ssingh-tamu/The-Only-WGT-FinalGIT/README.md

# The-Only-WGT-FinalGIT
ECEN CAPSTONE: 2 Channel Arbritrary Waveform Generating team #25 at TAMU. 

GitHub Repository: You must add your Instructors (kjnowka, pranav-d1993, johnlusher, skalafatis) and your TA as Collaborators. 

Sponsor:
Dr. John Lusher (johnlusher)

TA:
TBD
 
Contents:
Project data, reports, presentations, code, measurements, plans, and results. 

How to use code:
Download code as a zip file and run locally on personal device
Mobile App: Use VScode or other compatible IDE and Arduino IDE to start BLE search
