ssingh-tamu/The-Only-WGT-FinalGIT/Meeting Notes/Master Requirements- Summary from Lusher Meeting 1.docx

https://lucid.app/lucidchart/253e77ca-8b81-4c0a-8e63-2cc6b063a174/edit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

Master Requirements Document 1. System Overview

The project is a portable waveform generator with FPGA-based control and app-driven interface.
It must provide high-resolution, configurable signals across a range of frequencies, support standard lab equipment compatibility, and balance performance, portability, and usability.

System Objectives

- Generate high-quality arbitrary waveforms with 16-bit resolution.
- Provide portable and user-friendly operation with app-based control (ESP32).
- Ensure compatibility with standard lab measurement equipment (e.g., 50 Ω loads, BNC jacks).
- Demonstrate core capabilities in a 5-minute demo (signal generation, load driving, waveform control).

Key Design Constraints

1. Performance Limits
  - Sampling rate: ~1 MHz max (1M samples/sec).
  - Nyquist compliance: ≥2× rate required for 500 kHz signals (avoid aliasing).
  - Output frequency: 100 kHz max usable waveform frequency.
2. Resolution & Output Specs
  - 16-bit DACs (2 channels, parallel-based).
  - Output voltage: ±5 V.
  - Must drive 50 Ω load.
3. Form Factor & Portability
  - Device must fit into a “nice enclosure.”
  - Table-top form factor.
  - Thermal management (heatsinks/grounding for DC/DC converters)
4. Power
  - 12V DC Wall Plug
  - Must handle subsystem rails (FPGA, MCU, DAC, Op Amps, SRAM, etc.).
5. Interface
  - No onboard interface required → App-based UI preferred.
  - Must allow waveform preview/control via phone app.
  - Optional: local display for debugging.

Required Features

- Signal Generation
  - Waveforms: sine, sinc, triangle, trapezoid, invert.
  - User-defined / Optional: drawable waveforms.
  - Memory-backed waveform playback (FPGA + SRAM).
- FPGA Functionality
  - Index counter for waveform stepping.
  - RAM integration.
  - Load/playback control logic.
  - Configurable playback speed.
- Connectivity & App
  - App controls waveform generation, parameters, and playback.
  - Wireless communication via ESP32..
- Enclosure & I/O
  - BNC jacks for output.
  - Grounded, shielded enclosure.
  - Compact, user-friendly design.

Specifications Summary

Parameter | Requirement
DAC Resolution | 16-bit, 2 channels
Max Sampling Rate | Minimum ~1 MHz (1M samples/sec)
Max Output Frequency | Minimum: ~100 kHz
Output Voltage Range | ±5 V
Output Load | 50 Ω
Coupling | Selectable AC/DC
Waveforms Supported | sine, sinc, triangle, trapezoid, invert, custom
Memory | SRAM for waveform storage
Controller | FPGA (index counter, RAM, playback)
User Interface | IOS App (ESP32-based)
Ports | 2 BNC connectors (to connect to oscilloscope)
Power Options | DC 12V Wall Power

7. Demo Deliverables (Dec. 2)

- Demonstrate 16-bit waveform generation at ±5 V.
- Show multiple waveforms (sine, sinc, triangle, trapezoid, invert, etc).
- Control waveform parameters via app (ESP32).
- Prove ability to drive a 50 Ω load.
- Demonstrate clock speed control and waveform playback from memory.
