ssingh-tamu/The-Only-WGT-FinalGIT/Final Demo 403.docx

Csv capture command

(captures serial output of receiving esp which is what it is receiving via SPI)

py capture_csv.py COM3 115200

Standard Commands

Size: A standard STD packet is 17 bytes (136 bits): 'S' (1) + shape (1) + freq_mHz (4) + amp_mVpp (4) + offset_mV (4) + phase_deg (2) + channel (1).

Parsing: Check d[0] == 'S',read fields in order from d[1+] into StdParams (1-byte shape, then 4-byte LE freq_mHz, 4-byte LE amp_mVpp, 4-byte LE offset_mV, 2-byte LE phase_deg, and final 1-byte channel).

Sine

py send_awg.py --mode std --channel 0 --shape 0 --freq 1000 --vpp 6 --ofs 0 --phase 0

Square

py send_awg.py --mode std --channel 0 --shape 1 --freq 1000 --vpp 6 --ofs 0 --phase 0

Triangle

py send_awg.py --mode std --channel 0 --shape 2 --freq 1000 --vpp 6 --ofs 0 --phase 0

Sinc

py send_awg.py --mode std --channel 0 --shape 3 --freq 1000 --vpp 6 --ofs 0 --phase 0

Arb Command

Size/structure: ARB uses three packet types — META: 6 bytes ('A' + channel(1) + freq_mHz(u32)), DATA: 3 + 2*count bytes ('D' + count(u16 LE) + count×u16 LE samples), and END: 1 byte ('Z').

Parsing: Check d[0] and if it’s 'A' reset state and store channel + freq_mHz, if it’s 'D' verify n == 3 + 2*count and append the samples into arb_buf, and if it’s 'Z' then commit only if META was seen and exactly 1024 samples have been received.

py send_awg.py --mode arb --channel 0 --freq 1000 --file "C:\Users\knipp\Downloads\Capstone\arb_squiggle_1024.csv"

Code notes

Diff between arb and standard - It just looks at the first byte of the BLE packet. If it starts with 'S' it treats it as a standard packet; if it starts with 'A', 'D', or 'Z' it treats it as part of the arbitrary (ARB) protocol.

In my firmware, the ESP32-S3 is the SPI master and the FPGA is the SPI slave, so my code shifts 5-byte command frames (with opcode, address, and data) from the ESP32 into the FPGA whenever you write LUT samples or a frequency tuning word. Each fpga_spi_write_sram_sample or fpga_spi_write_nco_ftw call just packs those bits into a frame and uses SPI to clock them over the SCK/MOSI/CS pins so the FPGA can update its waveform memory and NCO

wavegen.cpp – This file defines the waveform parameters, the basic math for sine/square/triangle/sinc, and converts requested volt values into 16-bit DAC codes for a ±5 V range. It fills 1024-sample LUTs by stepping through phase, writes those samples into the FPGA’s SRAM over SPI, and computes/loads the NCO frequency tuning word based on the requested frequency. There are two main entry points: one that builds “standard” waveforms from parameters and one that uploads an arbitrary 1024-sample waveform array.

main.cpp – This is the Arduino entry point that initializes Serial, configures the SPI pins and clock for talking to the FPGA, and prints a short boot message. It calls the SPI setup function with specific ESP32-S3 pins (SCK=11, MOSI=9, CS=12) at 1 MHz, then starts BLE. The main loop just runs the BLE handler so incoming packets can trigger waveform updates.

fpga_spi.cpp – This file sets up the ESP32 FSPI bus with the chosen SCK/MOSI/CS pins and defines a simple 5-byte command frame with 3-bit opcodes in the first byte. Helper functions pack address and data or the frequency tuning word (FTW) into these frames and toggle chip select with a small delay so the FPGA can latch the data. It exposes two C-style functions: one to write a 16-bit sample into a selected SRAM bank/address and one to send a 32-bit FTW to the chosen NCO.

ble.cpp – This file creates a Nordic UART-style BLE service named “ESP32-JOE” with RX (write) and TX (notify) characteristics and tracks whether a client is connected. In the RX callback it parses legacy “STD” packets starting with ‘S’ into a StdParams struct (shape, frequency, amplitude, offset, phase, channel) or new “ARB” packets using a three-step protocol with ‘A’ for meta, ‘D’ for data chunks, and ‘Z’ for end. After a valid command is parsed, it calls the appropriate wavegen function to build and load either a standard LUT or an arbitrary LUT into the FPGA and update the frequency.
