ssingh-tamu/The-Only-WGT-FinalGIT/Final Demo notes.docx

Show that

- Bluetooth connectivity
- Can receive and parse all standard waveforms (sine, square, triangle, sinc) correctly across all value ranges (0 - 100khz, 0-10vpp, -5 to 5 offset, -180 to 180 phase)
- Can receive arbitrary meta and point data correctly
- Can produce 64k LUT and ftw correctly for all cases
- Can send it to a device via SPI
