ssingh-tamu/The-Only-WGT-FinalGIT/Power and Filter/Power and Filters.docx

Questions

Power

1. Should the DC/DC converter be buck, boost, buck boost, or inverters?
2. Will there be a mix of converters as each subsystem has its own specific rail needs? (This is a multi-rail power supply system)
3. Linear or Switching regulators? Or both?
4. What protections are necessary/should be considered for the power supply subsystem?
5. What is the main input? (battery?)
6. Main input: 12V Wall adapter (AC/DC Power Supply), Battery (Li-ion/Polymer), or Hybrid?
7. Switching buck for heavy digital loads -> LDOs to clean sensitive analog rails separate stage for high-voltage analog
8. Use of POL rails/implement a POL strategy/implement a POL architecture: the central source is the 12V adapter, and there will be POL converters (buck, boost, LDOs)

^ 12V adapter is the root of the system

^ from the 12V adapter, multiple POL converters branch out, each optimized for a subsystem, preventing one “noisy branch” from corrupting the whole system

Digital Circuits (Microcontrollers, FPGA): use switching buck regulators. Digital is mostly immune to noise, so a switcher’s noise won’t be too big of a problem

Analog Circuits (DAC): Use LDO due to needing near-perfect, noise-free rail. The power loss in using a LDO is acceptable because the needed current is low.

^ what type of linear regulator, aside from LDO (low-dropout regulator)? What about standard?

Note: The efficiency of switchers where it matters (Digital). The clean, quiet performance of LDOs where it’s critical (Analog).

*ensure that the components match the frequency

* use multisim/LTSpice or Proteus for simulation

* TA recommends 1-2 simulation before buying parts

### POL (Point of Load) Breakdown

1. Digital Rail (Buck 12V → 3.3V) [12 V → buck → 5 V → LDO → clean 3.3 V]
  - Powers MCU, FPGA, and Memory.
  - High current, efficient conversion.
  - Some digital noise is okay here.
2. Clean Analog Rail (LDO 3.3V)
  - Derived from 12V (or a 5V intermediate).
  - Powers DAC, because DACs need low-noise supplies to avoid introducing distortion.
3. Reference Rail (LDO 2.5V/Precision Voltage Reference IC)
  - Precision supply for DAC reference.
  - Like a ruler for the DAC’s output steps.
4. Isolated ±15V Rail (Isolated DC/DC)
  - Feeds Op-Amps and Filters.
  - Higher voltage allows rail-to-rail swing for strong analog outputs.
  - Isolation shields analog from digital ground noise.

IMPROVED POL (Point of Load) Breakdown

[12 V → buck → 5 V → LDO → clean 3.3 V]

1. Intermediate Distribution Rail

Rail Name: +5V_BUS

Voltage: +5V

Regulator Type: Switching Buck Converter (High-Efficiency)

Purpose: This is not a POL rail itself. It is an intermediate bus voltage. Its job is to efficiently step down the main 12V input to a lower voltage that all the subsequent POL regulators can use. This is more efficient than having each POL regulator step down directly from 12V.

Powers: The input to all the following POL regulators.

2. Digital Rails (Noisy, High-Current)

a) Digital I/O Rail

Rail Name: +3V3_DIG

Voltage: +3.3V

Regulator Type: POL Switching Buck Converter

Powers: FPGA I/O Banks, Microcontroller (MCU), Memory (RAM/Flash).

Why: These components are noisy and draw significant current. A high-efficiency buck converter is perfect. The 3.3V value is a standard voltage for modern digital logic ICs.

b) FPGA Core Rail (CRITICAL)

Rail Name: +1V2_CORE

Voltage: +1.2V (or as required by your specific FPGA)

Regulator Type: POL Switching Buck Converter (Must be placed very close to the FPGA)

Powers: The internal core logic of the FPGA.

Why: The FPGA core is the most demanding load: very low voltage, very high current, and extremely noisy. It must have its own dedicated POL regulator to ensure stability and prevent noise from spreading across the board.

c) DAC Digital Supply Rail

Rail Name: +3V3_DIG (or +1V8_DIG if needed)

Voltage: Set by DAC datasheet (often 3.3V or 1.8V)

Regulator Type: Ferrite Bead + Capacitor (Filtered from the +3V3_DIG rail)

Powers: The digital supply pin (DVDD) of the DAC.

Why: The DAC's internal digital logic is noisy. It is best practice to power it from the digital rail but add a simple filter (a ferrite bead and capacitor) to prevent its noise from going back into the main digital supply. This is often called a "pi filter."

3. Analog Rails (Clean, Low-Noise)

a) DAC Analog Supply Rail

Rail Name: +3V3_ANA

Voltage: +3.3V (or as required by the specific DAC)

Regulator Type: POL Low-Dropout (LDO) Regulator

Input: Powered by the +5V_BUS.

Powers: The analog supply pin (AVDD or VAA) of the Digital-to-Analog Converter (DAC).

Why: The DAC's analog circuitry is highly sensitive to power supply noise, which would directly corrupt the output waveform. The LDO takes the somewhat noisy +5V_BUS and produces a ultra-clean, low-noise rail for the DAC.

b) Precision Reference Rail (The "Master Ruler")

Rail Name: +2V5_REF

Voltage: +2.5V (or as required by the specific DAC)

Regulator Type: Precision Voltage Reference IC (This is not a regulator for power!)

Powers: Nothing. It provides a reference voltage.

Purpose: It connects to the DAC's reference input pin (VREF). This IC defines the DAC's full-scale output voltage. Its sole job is to be an absolutely stable, precise, and noise-free "ruler." If this voltage is wrong, every output voltage from the DAC is wrong.

4. Output Stage Rails (High Voltage, Isolated Dual Output DC/DC Converter Module)

Rail Name: +5V_ANA and -5V_ANA

Voltage: ±5V

Regulator Type: Isolated DC/DC Converter (or a non-isolated inverting converter for the negative rail if isolation isn't needed)

Powers: The output stage operational amplifiers (op-amps) and any associated filters.

Why:

Voltage Swing: The op-amps need a higher voltage supply (±15V) to generate large output signals (e.g., ±10V).

Bipolar Output: The negative rail (-15V) allows the output to swing below ground (0V), which is essential for standard waveforms like sine waves.

Isolation: The isolation creates a separate "analog ground" plane, shielding the sensitive output stage from the noisy "digital ground" plane.

*will need power jack soldered onto the board to plug in the wall adapter. During testing, solder the black and red wires to the footprint of the power jack

*may need extra rail to Memory

Load | Regulator Type | Input | Output | Purpose
Intermediate Bus Converter | Switching Buck | 12V Input | +5V_BUS | Efficiently steps the 12V input down to a lower voltage, typically 5V. This new +5V_BUS rail becomes the new, main power distribution rail for the entire board.
Digital Logic (FPGA I/O, MCU) | Switching Buck | +5V_BUS | +3.3V_DIG | Efficiently powers noisy, high-current digital chips.
FPGA Core | Switching Buck | +5V_BUS | +1.2V_CORE | Efficiently powers the hungry, noisy FPGA core. Must be very close to the FPGA.
DAC Analog Supply | LDO | +5V_BUS | +3.3V_ANA | Creates a clean rail from the noisy +5V_BUS for the sensitive DAC analog circuits.
DAC Digital Supply | Pi Filter | +3.3V_DIG | +3.3V_FILT | Filters noise from the digital rail for the DAC's digital pins. (Ferrite bead + capacitors).
DAC Reference Voltage (VREF) | Precision Voltage Reference IC | +3.3V_DIG or +5V_BUS | +2V5_REF | It connects to the DAC's reference input pin (VREF). This IC defines the DAC's full-scale output voltage. Its sole job is to be an absolutely stable, precise, and noise-free "ruler." If this voltage is wrong, every output voltage from the DAC is wrong.
Output Op-Amps | Isolated DC/DC Converter | 12V Input | ±5V_ANA | Creates high-voltage, isolated rails for the output stage to swing large signals.
Output Stage Op-Amps (Cleanup) | LDO Regulators (Optional) | ±5V_ANA | ±5V_CLEAN | Further cleans the noisy output of the isolated converter, providing pristine power to the most sensitive op-amps.

Rail Organization

Subsystem | Rail Name | Purpose | Voltage | Critical Requirements
MCU | +3.3V_DIG | Powers the MCU, FPGA I/O pins, and general digital logic. | +3.3V | N/A
Memory | +1.5V_DDR | | +1.5V | N/A
Memory | +0.75V_VTT | | +0.75V | Must source/sink current
FPGA | +1.2V_CORE | | +1.2V | High Current, Low Noise
FPGA | +3.3V_DIG | | +3.3V | N/A
DAC | +3.3V_ANA | | +3.3V | Ultra-Low Noise
DAC | +3.3V_FILT | | +3.3V | Filtered
DAC | +2.5V_REF | | +2.5V | Precision, Stability
Filter + Amp | +15V_ANA | | +5V | Isolated from Digital GND
Filter + Amp | -15V_ANA | | -5V | Isolated from Digital GND
Enclosure | +3.3 | Indicator Lights | 2.1V | Resistor in Series to nudge input voltage down a little

MCU

Rail: +3.3V_DIG

Memory (DDR)

Core Rail: +1.5V_DDR (for memory chips' VDD)

Termination Rail: +0.75V_VTT (for signal integrity)

FPGA

Core Rail: +1.2V_CORE (for internal logic)

I/O Rail: +3.3V_DIG (for bank voltages)

DAC

Analog Supply Rail: +3.3V_ANA (for AVDD)

Digital Supply Rail: +3.3V_FILT (for DVDD, Pi Filter branching from Analog Supply Rail)

Reference Rail: +2.5V_REF (for VREF)

Filter + Amplifier (Output Stage)

Positive Rail: +5V_ANA

Negative Rail: -5V_ANA

### DUAL DAC DESIGN FOR TWO-CHANNEL (how will this affect the power design?)

Filter

1. Revision 1:

DAC output → low-pass to smooth signal → offset summing Amp + variable gain amp → output buffer amp → high-pass (AC coupling, blocks DC) → over-current + short-circuit protection → output

2. Revision 2:

DAC output → local RC → reconstruction LPF → diff→single (if needed) → offset summing amp + PGA → final buffer/driver → selectable AC coupling (relay bypass for DC) → TVS + current sense + active limiter → output connector (switchable 50Ω pad)

3. Revision 3 (Current-output DAC):

DAC -> I-V Converter (opamp) -> Reconstruction LPF -> Variable Gain Amp (VGA) -> Offset Summing -> Output Buffer

4. Revision 4 (Voltage-output DAC):

Voltage-Output DAC -> Reconstruction LPF -> Variable Gain Amp (VGA) -> Offset Summing -> Output Buffer

Stage Purpose User Control

Reconstruction LPF Smooths the DAC's stairsteps No (Fixed by design)

PGA (Amp Stage) Sets the output amplitude Yes (Via App)

Output Buffer Provides current, low impedance No (Always on)

Protection Guards against shorts/ESD No (Always on)

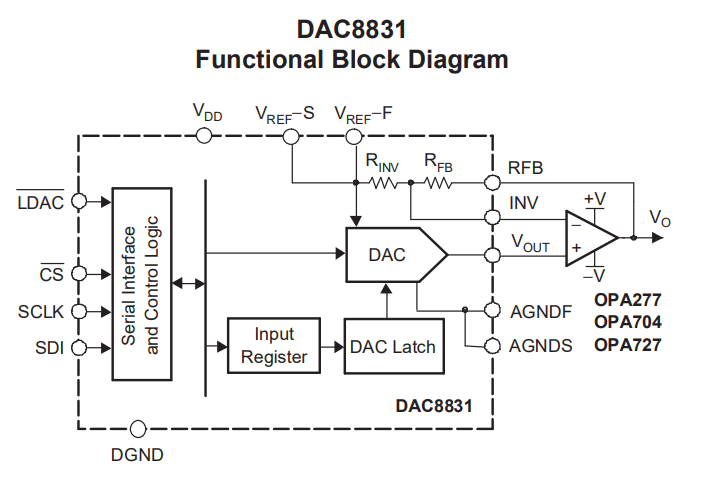
[picture p5: figure]

Videos

- https://www.youtube.com/watch?v=XYrpfNqrRRY

—----------------------------------------------------------------------------------------------------------------------------

Additional Notes:

The Workflow

The Microcontroller (running firmware) handles the "brain" tasks: communicating with the iPhone/Android app, reading the stored waveform from memory, and configuring the FPGA.

The FPGA (running the custom logic) handles the "brawn" tasks: reading the waveform data at a precise, high-speed rate from memory and streaming it to the DAC. This is its core job.

The DAC takes the high-speed digital number stream from the FPGA and converts it into a stepped analog signal.

The Analog Stage (Filter and Amplifier) smooths the DAC's stepped output into a clean waveform and amplifies it to the desired voltage level.

The Power's Job: Is to keep all of this running without any part of the system causing another part to misbehave. The digital switching noise from the FPGA and memory must not leak into the analog stages, which is why we use separate, filtered POL rails and careful layout.

### Subsystem Dependencies

- App → MCU: The phone app sends commands (frequency, waveform shape) to the microcontroller.
- MCU → FPGA: The MCU configures the FPGA and tells it what waveform data to use.
- FPGA ↔ Memory: FPGA pulls waveform samples from memory.
- FPGA → DAC: FPGA clocks digital samples into the DAC.
- DAC → Op-Amps + Filters: DAC produces a staircase signal, which op-amps filter and buffer into smooth analog waveforms.
- Op-Amps + Filters → Output: Final waveform goes to the user.

—----------------------------------------------------------------------------------------------------------------------------

### 1. Where are the waveforms stored?

- Memory (Flash, SDRAM, or SRAM) stores the waveform tables (e.g., sine, triangle, custom user-defined shapes).
- Think of memory as a library of sheet music.

### 2. Role of the MCU

- The MCU is like the conductor. It doesn’t play the waveform itself, but it decides:
  - Which waveform to use (sine, square, etc.).
  - At what frequency/amplitude to play it.
  - When to start/stop.
- The MCU gets these instructions from the App (via USB, Bluetooth, WiFi, etc.).
- The MCU then configures the FPGA:
  - Tells it where in memory to look.
  - Tells it what playback rate (sample clock divider).
  - Sets channel parameters (Ch1 vs Ch2).

### 3. Role of the FPGA

- The FPGA is the sheet music player — very fast, very parallel.
- Once the MCU sets it up, the FPGA:
  - Reads digital samples from memory (at the right speed).
  - Streams them out as a sequence of numbers to the DAC.
  - Can handle two channels independently (since you want two different frequencies at once).

### 4. Role of the DAC

- The DAC is the instrument that turns digital sheet music (sample numbers) into real analog voltages.
- It outputs a “staircase” approximation of the waveform.

### 5. Role of the Analog Output Stage

- Op-amps + filters are the sound engineers:
  - Smooth out the DAC’s staircase (low-pass filter).
  - Buffer the signal so it can drive cables/loads.
  - Scale amplitude if needed.

Note

Nyquist: sampling rate is 2x the frequency (otherwise, alias)

Limit DAC to 1MHz, fastest signal is 100kHz

2 DAC

Ram holds waveform

16-bit DAC

1Mega sample/sec

FPGA has to load memory: loadback() and configuration (talk to app to download waveform)

Output of opamp no good, need filter

50ohm impedance load

—----------------------------------------------------------------------------------------------------------------------------

### INFORMATION NEEDED FOR POWER DESIGN

MCU - ESP32

https://www.espressif.com/sites/default/files/documentation/esp32-wroom-32_datasheet_en.pdf

Parameter | Purpose | Where to Find It | Value
Core Voltage | Power | https://www.espressif.com/sites/default/files/documentation/esp32-wroom-32_datasheet_en.pdf | 3-3.6 (V)
Core Current (Max) | Power | Same | 0.5A minimum
I/O Voltage | Control | Same | VDD
Any Special Rails

FPGA - https://docs.amd.com/v/u/en-US/ds162

Parameter | Purpose | Where to Find It | Value
Core Voltage (VCCINT)
Core Current (Max)
I/O Bank Voltages (VCCIO)
I/O Bank Currents
Auxiliary Voltage (VCCAUX)
Auxiliary Current
Power-On / Off Sequence

Memory - https://www.issi.com/WW/pdf/62WV12816ALL.pdf

Parameter | Purpose | Where to Find It | Value
Type & Part Number
Core Voltage (VDD)
Core Current (Max)
Termination Voltage (VTT)
I/O Voltage (VDDQ)

DAC - TI DAC 8820

chrome-extension://efaidnbmnnnibpcajpcglclefindmkaj/https://www.ti.com/lit/ds/symlink/dac8820.pdf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

Parameter | Purpose | Where to Find It | Value
Analog Supply Voltage (AVDD/VAA)
Analog Supply Current (I_AVDD)
Digital Supply Voltage (DVDD) | Power | datasheet | 2.7-5.5
Digital Supply Current (I_DVDD) | power | datasheet | 3-5uA
Reference Input Voltage (VREF) | Analog output | datasheet | N/A Depends on analog ref around it Analog Output Stage filter section
Reference Input Current (I_VREF)

Analog Output Stage Filters

Parameter | Purpose | Where to Find It | Value
Op-Amp Supply Voltage Range
Op-Amp Supply Current (per amp)
Output Voltage Swing
