ssingh-tamu/The-Only-WGT-FinalGIT/PCB/PCB Notes.docx

- S3 can work with just usb recep
- So we can exclude cp2102n and USB to UART
- Also dont need auto program circuit can exclude that
- chrome-extension://efaidnbmnnnibpcajpcglclefindmkaj/https://dl.espressif.com/dl/schematics/SCH_ESP32-S3-DevKitC-1_V1.1_20221130.pdf
- es

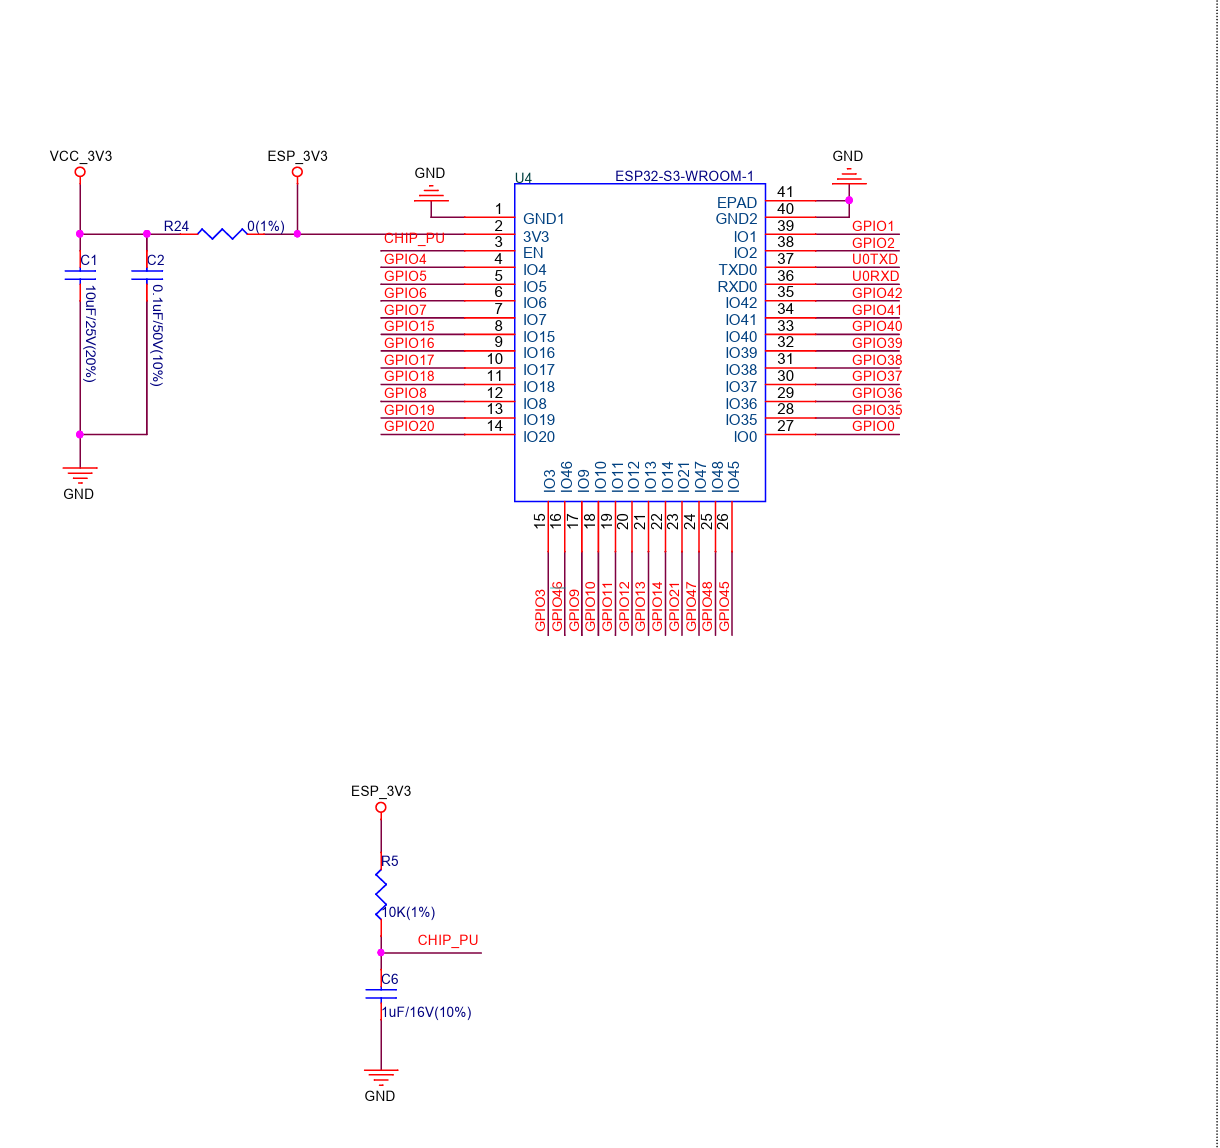
[picture p6: figure]
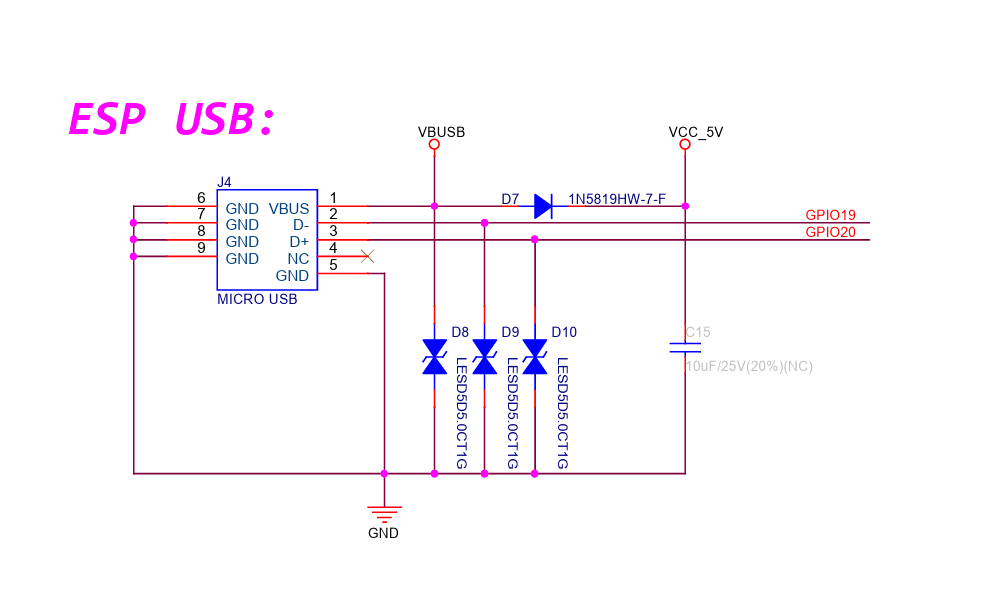
[picture p7: figure]
