ssingh-tamu/The-Only-WGT-FinalGIT/Meeting Notes/10_27 Notes.docx

Zoom Link: https://us04web.zoom.us/j/73251880836?pwd=7DvYnqgihGabgiac9zAaB7KOCzAVjC.1

To Do:

- Subsystem Updates
- Status Update Slides

Notes:

Serene:

- On track with subsystem, finished slides

Brayden:

- Ordered PCB will arrive Nov 2nd, will practice soldering tmr, will start coding tmr, slides finished

Joe:

- Slides finished, plans to populate pcb tmr

Be ready to do a couple dry run presentations tmr during the lab!!!
