ssingh-tamu/The-Only-WGT-FinalGIT/Meeting Notes/9_2_ Introductions Meeting.docx

To Do:

- Introductions + Backgrounds
  - Technical Strengths/Weaknesses
- Compile Team Schedules
  - Set up regular meeting times
- Talk about Project
- Subsystem Brainstorming

Project Overview:

Design and implement an Arbitrary Waveform Generator (AWG) capable of generating two independent analog waveforms, each at different user-defined frequencies, based on pre-stored waveform data. Users will control the AWG through a mobile app (iOS/Android?), which communicates with the hardware system comprising:

- Microcontroller (MCU) for control and interface logic
- FPGA for high-speed waveform generation
- External memory to store arbitrary waveform data
- Digital-to-Analog Converters (DACs) for converting digital waveforms to analog
- Analog output stages with filters to clean the signal
- DC/DC converters for power regulation

Goal:

This system will allow users to choose waveform shapes, frequency, amplitude, and output channels via the app and transmit those settings to the hardware.

Main Features:

1. Dual-channel waveform output
2. User-defined waveform selection (stored in memory)
3. Frequency and amplitude control
4. Mobile app interface
5. Analog output with filtering
6. DC power regulation for portability

Flow Chart:

[ Mobile App ] <--Bluetooth/WiFi--> [ Microcontroller ] <---> [ FPGA ]

[ External Memory (Waveforms) ]

[ Dual DACs ] ---> [ Analog Filters ] ---> [ Output ]

[ Power: DC/DC converters ]

Subsystems:

Subsystem | Main Role | Key Components
Mobile App | User interface & control | Flutter/React Native, BLE/WiFi
Microcontroller | System coordination & communication | STM32, ESP32, Teensy
FPGA | Digital waveform generation | Xilinx/Lattice FPGA, DDS/NCO logic
External Memory | Stores waveform data | QSPI Flash, SRAM
DAC | Converts digital to analog | DAC8562, AD9708
Analog Output Stage | Filters and buffers analog signals | Op-amps, RC filters
Power Supply | Regulates all system voltages | DC/DC converters, LDOs
Communication Buses | Transfers data between components | SPI, UART, I2C, parallel

Potential Team Responsibility Breakdown:

### Team Member 1: Mobile App & Communication Interface

Main Focus: User Interface, App Logic, and Communication with MCU

#### Responsibilities:

- Design and implement the mobile app UI (iOS & Android)
- Allow user to:
  - Select waveform type
  - Set frequency & amplitude
  - Start/stop waveform output
- Implement Bluetooth or WiFi communication
- Define and document the data protocol (e.g., JSON or binary messages) between app and MCU
- Implement feedback/status display from device

#### Tools:

- Flutter (cross-platform), or Swift (iOS) + Kotlin (Android)
- BLE or WiFi (TCP/UDP) stack
- Serial monitor & mobile debugging tools

#### Interfaces With:

- Team Member 2 (MCU)
- Must define command structure early to enable parallel work

### Team Member 2: Microcontroller Firmware & System Controller

Main Focus: Command parsing, communication handling, and FPGA configuration

#### Responsibilities:

- Set up and manage Bluetooth/WiFi connection on MCU
- Receive commands from mobile app
- Parse commands and generate control signals for FPGA (e.g., waveform ID, frequency values)
- Initialize system peripherals
- Optionally handle waveform data loading into external memory
- Provide status messages back to app
- Handle power-on/reset sequencing for the system

#### Tools:

- C/C++ or Arduino framework
- STM32CubeIDE, PlatformIO, or ESP-IDF
- UART/SPI/GPIO to interface with FPGA

#### Interfaces With:

- Team Member 1 (App)
- Team Member 3 (FPGA): Define control protocol for waveform config
- Team Member 4 (Power/Analog): May need to coordinate power control sequencing

### Team Member 3: FPGA Logic Design & Memory Interface

Main Focus: High-speed waveform generation and data playback logic

#### Responsibilities:

- Implement dual-channel waveform generator using:
  - DDS (Direct Digital Synthesis) or counter-based playback
- Create finite state machine (FSM) for:
  - Reading waveform data from memory
  - Handling dual output synchronization
- Interface with:
  - External memory (QSPI/SRAM)
  - DAC (SPI or parallel)
- Accept configuration parameters from MCU (via SPI/UART/GPIO)
- Provide waveform timing accuracy and channel separation

#### Tools:

- Verilog/VHDL, Vivado or Lattice Diamond (depending on FPGA)
- ModelSim/ISE for simulation
- Testbench development

#### Interfaces With:

- Team Member 2 (MCU): Define config protocol
- Team Member 4 (DAC/Analog): Define DAC signal format and timing

Team Member 4: Analog Output Stage, DAC, and Power System

Main Focus: Convert digital samples to analog, filter and amplify output, and manage power regulation

#### Responsibilities:

- Select and configure DACs (dual-channel or two separate)
- Design analog output filters (anti-aliasing, op-amp buffers)
- Design and build power supply system:
  - DC-DC converters (buck/boost)
  - Clean power rails for analog, digital, and FPGA sections
- Perform signal integrity testing (oscilloscope measurements)
- Assist in PCB layout for mixed-signal performance (digital/analog isolation)
- Handle signal conditioning for both waveform channels

#### Tools:

- LTSpice, Altium/KiCad, Oscilloscope, Signal generator
- Power supply modules or custom DC/DC design
- Soldering/debug tools for analog prototyping

#### Interfaces With:

- Team Member 3 (FPGA): DAC input format & timing
- Team Member 2 (MCU): Ensure sequencing or enable pins for power control

Meeting Notes:

Potential Subteams

App/ Mem

Microcontroller

DAC FPGA

Power/Analog (Note: would need current draw table from components in other subsystems)

Notes/References:

DIY a Signal Generator: https://www.instructables.com/DIY-FunctionWaveform-Generator/

$20 AWG: https://www.instructables.com/Arbitrary-waveform-generator/

Function Generator: https://www.allaboutcircuits.com/projects/how-to-DIY-waveform-generator-analog-devices-ad9833-ATmega328p/

Homemade DAC: https://www.instructables.com/Homemade-Quality-DAC-Is-Easy/

DAC AD Converter: https://www.instructables.com/Homemade-DAC-AD-Converter/

DIY Analog Function Generator (reference): https://www.reddit.com/r/electronics/comments/17tij5x/my_diy_analog_function_generator_i_built_a_two/

Digital Direct Synthesis https://www.analog.com/en/resources/analog-dialogue/articles/all-about-direct-digital-synthesis.html

Meeting with Lusher Questions: QUESTIONS DUE 9/3 MIDNIGHT

Sorted List by Category:

1. System Design & Architecture
  a. Can we buy a DAC or do we have to make our own?
  b. What kinds of microcontrollers can we use? Is there anything we can’t use the microcontroller to do, like store the memory of the signal?
  c. Should the DC/DC converter be buck, boost, or buck boost?
  d. Power constraints: sourcing
  e. What protections are necessary for the power supply subsystem?
  f. Local or Cloud Memory?
2. Specifications & Performance
  a. Design specs?
  b. What should the resolution of the output signal be?
  c. What is the maximum output frequency and useful signal bandwidth per channel?
  d. What is the Frequency range?
  e. What is maximum amplitude?
  f. What are the required DC accuracy?
  g. How many values per arbitrary waveform period?
3. User Interface & Display
  a. Do we need a display on the waveform generator?
  b. Does any data need to be displayed on the phone app that needs to be communicated back from the waveform generator?
4. Power & Portability
  a. Portability constraints? Should this device be a table-top machine or a handheld device?
  b. Battery Life constraints? Wireless capabilities
5. Functionality & Use Cases
  a. What is the primary intended application for the AWG? Should the signal be tested against different \[loads/environments]?
  b. Should we have preset waveforms (square, triangle, sin, etc)?

Design Specifications:

- Filtering + Power → Salina
- DAQ + FPGA → Brayden
- Team Spokesperson+ Mobile Device + Communication Interface → Serene
- Microcontrollers + Current Waveform Generators Stats Sheet + Feasibility → Joe

Assignment:

- Research your subsystem and determine scope and feasibility
- Ideally, how would your subsystem work?
- Create a list of materials you’d need to purchase
- Suggest a game plan for your subsystem
  - Outline What parameters you need and from what subsystem
  - Outline what parameters you will provide and for what subsystem
- Create soft deadlines for your subsystem

TA Office

11-1 Mondays

ConOp Report Due in 2 weeks
