ssingh-tamu/The-Only-WGT-FinalGIT/Meeting Notes/9_4  Meeting w_Lusher FINIAL Q.docx

Meeting with Lusher Questions: QUESTIONS DUE 9/3 MIDNIGHT

Sorted List by Category:

1. System Design & Architecture
  a. Can we buy a DAC or do we have to make our own?
  b. What kinds of microcontrollers can we use? Is there anything we can’t use the microcontroller to do, like store the memory of the signal?
  c. Power constraints: sourcing
  d. What protections are necessary for the power supply subsystem?
  e. What will be the exact purposes for the output filters?
  f. Local or Cloud Memory?
2. Specifications & Performance
  a. Design specs?
  b. What should the resolution of the output signal be?
  c. What is the maximum output frequency and useful signal bandwidth per channel?
  d. What is the Frequency range?
  e. What is maximum amplitude?
  f. What is the required DC accuracy?
  g. How many values per arbitrary waveform period?
  h. What output voltage ranges do we need?
  i. What load impedances must we support?
  j. Do we want both AC-coupled and DC-coupled outputs, or only one? (allow selectable AC coupling?)
3. User Interface & Display
  a. Do we need a display on the waveform generator?
  b. Does any data need to be displayed on the phone app that needs to be communicated back from the waveform generator?
4. Power & Portability
  a. Portability constraints? Should this device be a table-top machine or a handheld device?
  b. Battery Life constraints? Wireless capabilities
  c. Main input: 12V Wall adapter (AC/DC Power Supply), Battery (Li-ion/Polymer), or Hybrid?
  d. Do we need isolated power rails for analog and digital sections, or is careful grounding enough?
  e. Is thermal management (heatsinks, airflow) a concern for the DC/DC converters or LDOs?
  f. What are the required voltage rails for each subsystem (FPGA, MCU, memory, DAC)
  g. What are the maximum current draws for each rail under worst-case load?
  h. What noise level is acceptable on the analog rails?
  i. Main input: 12V Wall adapter (AC/DC Power Supply), Battery (Li-ion/Polymer), or Hybrid?
5. Functionality & Use Cases
  a. What is the primary intended application for the AWG? Should the signal be tested against different \[loads/environments]?
  b. Should we have preset waveforms (square, triangle, sin, etc)?
