ssingh-tamu/The-Only-WGT-FinalGIT/Project Deliverables/CONOPS/CONOPS_V1_TheOnlyWGT.docx

Arbitrary Waveform Generator

Brayden Donovan

Salina Teng

Serene Singh

Joe Knipper

Concept of Operations

Concept of Operations

for

Arbitrary Waveform Generator

Team <02>

Approved by:

Serene Singh 09/16/2025

_____________________________________

Project Leader Date

Dr. John Lusher 09/16/2025

_____________________________________

Prof. Kalafatis Date

Jianhan Pan 09/16/2025

_____________________________________

T/A Date

Change Record

Rev. | Date | Originator | Approvals | Description
v1 | 9/16/2025 | Serene Singh | The Only WGT | Draft Release

Table of Contents

Figure 1: Comprehensive Flow Chart of Proposed AWG System 4

1. Executive Summary 4

2. Introduction 6

2.1. Background 6

2.2. Overview 6

2.3. Referenced Documents and Standards 7

3. Operating Concept 8

3.1. Scope 8

3.2. Operational Description and Constraints 8

3.3. System Description 8

3.4. Modes of Operations 8

3.5. Users 9

3.6. Support 10

4. Scenario(s) 11

4.1. University Lab 11

4.2. Debugging Embedded System 11

5. Analysis 11

5.1. Summary of Proposed Improvements 11

5.2. Disadvantages and Limitations 12

5.3. Alternatives 12

5.4. Impact 13

List of Figures

# Figure 1: Comprehensive Flow Chart of Proposed AWG System

# 1. Executive Summary

This project presents the design and implementation of a two-channel Arbitrary Waveform Generator (AWG). AWGs are critical tools in electrical engineering and research, enabling the generation of precise, user-defined signals for testing and characterizing circuits, systems, and devices. Unlike traditional function generators, AWGs offer the flexibility to create complex, custom signals with high accuracy.

The objective of this project is to develop a compact, cost-effective, and user-friendly AWG capable of producing two independent arbitrary waveforms, either individually or simultaneously, with adjustable frequency, amplitude, and offset. The system integrates two 16-bit digital-to-analog converters (DACs) driven by a microcontroller/FPGA for waveform storage, sequencing, and timing. Each channel supports common signals such as sine, square, triangle, and sinc waveforms, as well as adjustable user-defined waveforms.

The outputs are designed to achieve a maximum signal frequency of 100 kHz with a voltage range of ±5 V while driving a 50 Ω load, ensuring adequate resolution, stability, and compatibility with laboratory equipment. To enhance usability, a custom mobile application provides intuitive control of the device, allowing users to create, select, and preview waveforms from their device.

In conclusion, the completed AWG will deliver two fully independent channels with accurate signal generation and low distortion. Testing will confirm stable operation across the supported frequency range, with the ability to generate both standard and custom waveforms. The system’s performance will demonstrate the successful integration of digital and analog design principles while providing a compact, cost-effective, and user-friendly AWG.

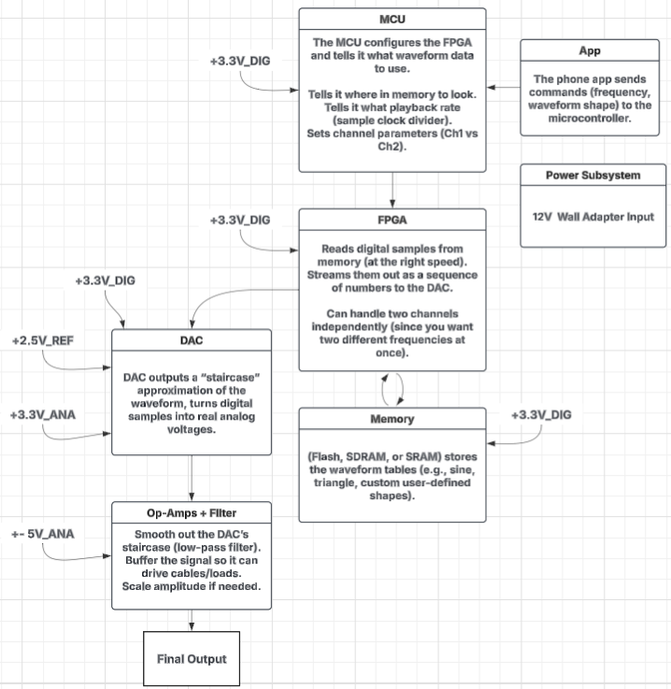
[picture p18: figure]

Figure 1: Comprehensive Flow Chart of Proposed AWG System

# 2. Introduction

In electrical engineering, signal generation plays a critical role in evaluating circuits, devices, and systems. While traditional function generators provide basic waveform outputs, modern applications often require more flexibility and control over specific signal characteristics. This project addresses these needs through the development of a two-channel arbitrary waveform generator (AWG) designed to deliver high-performance user-defined signals in a compact and cost-effective platform.

## 2.1. Background

Traditional function generators are widely used in laboratories and industry in order to provide fixed or limited waveform outputs such as sine, square, and triangle waves. These systems lack the flexibility required for modern electronic applications that need precise control over waveform parameters such as frequency, amplitude, and offset. Commercial AWGs offer these capabilities, but many available systems are expensive, bulky, and confusing for an amateur user.

The following paper addresses these limitations by introducing a compact, cost-effective two-channel AWG that provides high 16-bit resolution with user-defined signal generation through a mobile IOS app. By leveraging commercial off the shelf components, this design will offer amateur users a cost-effective and simple way to generate arbitrary waveforms from their personal device.

## 2.2. Overview

The proposed arbitrary waveform generator (AWG) is designed to deliver high-performance, customizable signal generation in a compact, user-friendly platform. The system will enable users to define, upload, and edit waveforms while maintaining high resolution, stable frequency output, and multichannel operation.

Key Design Features:

- Two Independent Output Channels – The AWG will be able to support two channels, and each channel can support separate waveform configurations. The output voltage will be ±5 V.
- High Sampling Rate & Resolution – The AWG will feature a 16-bit resolution with a max sampling rate of 1MHz per second. It will be able to output max usable frequencies of 100kHz.
- User-Defined Signal Control – Waveform parameters will be inputted by the user using a mobile app, IOS/Android. The user will also have the ability to draw arbitrary waveforms directly.
- Power/Interface– The device will utilize one 12V DC Wall Plug for power. The enclosure will have indicator lights to show the status of the system and will have two BNC jacks to output the generated waveform. .
- Compatibility– The device will be compatible with standard lab measurement equipment, such as an oscilloscope, and will have the ability to drive a 50 Ω load.

Overall, the project focuses on delivering a high-performance AWG that is low-cost and enables basic creation and control over arbitrary waveforms effectively.

## 2.3. Referenced Documents and Standards

[1] Espressif Systems, ESP32 Series Datasheet: ESP32-D0WD, ESP32-D0WDQ6, ESP32-D2WD, and ESP32-S0WD, ver. 3.9, 2023. [Online]. Available: https://www.espressif.com

[2] Texas Instruments, DAC8831: 16-Bit, Ultra-Low Glitch, Voltage Output DAC, datasheet SBAS289C, 2015. [Online]. Available: https://www.ti.com

[3] Keysight Technologies, 33500B Series Trueform Waveform Generators – Data Sheet, publication no. 5991-3563EN, 2017. [Online]. Available: https://www.keysight.com

[4] E. Murphy and C. Slattery, “All About Direct Digital Synthesis,” Analog Dialogue, vol. 38, no. 3, Aug. 2004. [Online]. Available: (https://www.analog.com/en/resources/analog-dialogue/articles/all-about-direct-digital-synthesis.html)https://www.analog.com/en/resources/analog-dialogue/articles/all-about-direct-digital-synthesis.html

[5] Use EA’s Arbitrary Function Generator to Output Custom Voltage or Current Waveforms. (2024,May).Tek.com. https://www.tek.com/en/blog/use-eas-arbitrary-function-generator-to-output-custom-voltage-or-current-waveforms

‌

# 3. Operating Concept

## 3.1. Scope

Our project is to design and create a dual-channel arbitrary waveform system which allows users to define waveforms and control their parameters through a mobile application. The system will consist of a mobile application, microcontroller, FPGA, and a series of analog filters that will be used to create high frequency, customizable waveforms from parameters inputted into a user-friendly interface.

## 3.2. Operational Description and Constraints

The AWG will be capable of defining custom frequencies and aptitudes of sine, square, triangle, sinc, and arbitrary waveforms as specified by the user. The machine will be able to produce two output waveforms either individually or simultaneously, increasing its possible utilization.

## 3.3. System Description

The arbitrary waveform generator can be split into four major parts; The mobile application, microcontroller, FPGA, and the analog filters. The mobile application allows the user to interact with the AWG by collecting values like the frequency, amplitude, offset, and type of waveform from the user. When the user has finished specifying the parameters of their waveform, the data is then sent to the machine through a wireless connection to the microcontroller. The microcontroller then sets the data bits that control the amplification of the circuit and communicates the mode of operation to the FPGA. The microcontroller also calculates a list of specific time values for the FPGA to sample from the waveform in order to control the frequency through downsampling. The microcontroller sends all necessary waveform configuration data to the FPGA in a serialized format while in the configuration mode of operation. This data is received by the FPGA and is stored in memory. The FPGA then uses this stored data while in the generation mode of operation to retrieve the correct binary values from memory. These binary values are then sent to the DAC in a serialized format. The DAC converts the binary values retrieved from memory into an analog signal which is then amplified according to the user defined value, buffered so that it can adequately drive the load, and smoothed with a low pass filter. The signal is then outputted with a BNC jack, which allows the user to easily use their generated waveform.

## 3.4. Modes of Operations

Our device has two main modes of operation, configuration and generation.

- Configuration – During configuration mode, necessary values are calculated using the user defined waveform parameters. These values are then sent to the AWG by a wireless connection to the microcontroller. Any necessary values are passed to the FPGA to be stored in memory, and all necessary control bits are set by the microcontroller.
- Generation – In this generation mode, the FPGA iterates over set values in memory to produce the correct waveform at the intended frequency. The binary values retrieved from memory are passed to the DAC to be converted into an analog waveform, which is then amplified and filtered.

## 3.5. Users

1. Who will be using your system

Users of the Arbitrary Waveform Generator (AWG) are divided into two categories: Primary and Secondary.

Primary users include individuals who rely on the AWG extensively as a critical tool for generating custom electrical signals required in applications such as prototyping, testing, troubleshooting, validation, calibration, and characterization of an electrical system. These individuals may involve Test Engineers, Electrical Engineers, R&D Scientists, Lab Managers, Maintenance & Calibration Engineers, and Technicians. Their work often requires the AWG’s high precision, reliability, and repeatability to create standard and arbitrary waveforms for a wide range of applications.

Secondary users include individuals who use the AWG in an academic or training environment. These individuals often involve Students and Educators. Secondary users leverage the AWG as a learning tool to gain valuable hands-on experience in understanding signal processing, waveform generation, digital/analog signal behavior, and validating experimental results in laboratory settings.

2. Level of training required for installation

The level of training required for installation is minimal. The AWG is largely designed as a ‘plug and use’ device, backed-up by its straightforward set-up and ease of integration into testing or production environments. Individuals such as an engineer with basic understanding with test and measurement equipment can perform successful installation of the AWG to advance it into operation.

3. Level of training required for use

The level of training required to operate the AWG involves an intermediate level of technical understanding regarding topics such as signal characteristics, waveform properties (e.g., frequency, phase shift, amplitude), and interaction between signal and device when in testing. Moderate formal training or self-conducted research are recommended for users who are new to using the device or want to understand the full functionality and capability offered by the system.

4. Who will benefit from your proposed system

Individuals who rely extensively on the AWG to create standard and arbitrary waveforms for laboratory, production, or testing purposes will benefit greatly from the proposed AWG system. For instance, Engineers and Product Developers benefit by being able to design and generate arbitrary custom signals that replicate realistic signal conditions under testing environments. This functionality allows them to validate new designs, leading to higher-performing and higher-quality products.

## 3.6. Support

- User Manual

A detailed and comprehensive user manual will be provided with each Arbitrary Waveform Generator (AWG) unit. The manual will cover essential steps for device set-up and usage, including installation procedures, basic operation guidelines, safety rules. Example test procedures will also be included, as well as troubleshooting guidelines for common issues, situational examples, and recommended configurations for different usages.

- Technical Support

Technical support will be provided through a tiered support structure. For common issues such as installation difficulties, basic configurations, amongst many other frequently asked questions, users can access assistance through email or phone. For more advanced issues such as hardware malfunction or application challenges, specialized support will be available for in-depth consultation and troubleshooting. Support of all tiers will be provided in a timely manner, regardless of their complexity.

- Software & Firmware Updates

The AWG will be supported and maintained with a program of downloadable software and firmware updates. Updates will provide bug fixes, new features, and performance improvements. Maintenance of the AWG will involve ensuring ongoing compatibility with evolving operating systems and interfaces. Users will be notified of updates through vendor communication platforms/email, and update installation guidelines will be provided to ensure a successful system upgrade.

# 4. Scenario(s)

## 4.1. University Lab

In a university lab setting, a student uses the custom Arbitrary Waveform Generator (AWG) to supply synchronized test signals for a mixed-signal circuit experiment. After powering on the AWG and connecting to it via Bluetooth, the student programs Channel 1 to output a 10 kHz sine wave and Channel 2 to output a 10 kHz square wave at 10 Vpp, ensuring both are phase-aligned. The AWG’s direct digital synthesis (DDS) core and DACs generate the signals from the same clock, while precision op-amps and output buffers condition them for clean delivery into a 50 Ω circuit load. The student connects these outputs to both the circuit under test and an oscilloscope, verifying that the waveforms are properly displayed.

## 4.2. Debugging Embedded System

In an embedded systems' lab, a student is testing a microcontroller circuit that needs both a stable clock reference and a trigger pulse for synchronization. The AWG is configured so Channel 1 outputs a 1 MHz sine wave to emulate an external oscillator, while Channel 2 generates a 10 kHz square wave used as a periodic trigger. Because both channels share the same DDS clock, the signals are inherently synchronized, letting the student align events precisely without drift. The microcontroller reads the square-wave trigger while processing the sine input, and the student monitors timing relationships on an oscilloscope. This setup demonstrates the AWG’s ability to act as a compact, multipurpose signal source for debugging timing-sensitive digital-analog systems.

# 5. Analysis

## 5.1. Summary of Proposed Improvements

The arbitrary waveform generator would facilitate multiple enhancements to both laboratory and educational settings by addressing current limitations in signal generation and accessibility. Key proposed improvements include:

- Expanded Waveform Capabilities

The AWG’s design supports the generation of a wide range of standard and arbitrary signals across multiple frequency ranges (e.g., sine, sinc, square, triangular, and fully user-defined arbitrary waveforms). This enhanced signal customization enables engineers, researchers, and students to test devices under highly customized scenarios using real-world signals that traditional waveform generators cannot easily accomplish.

- Mobile Interface with Flexible Signal Design

Users gain the ability to interact with the AWG using a mobile interface that allows waveform creation by drawing signals directly on a touchscreen device. The interface will estimate the signal parameters (e.g., amplitude, frequency, standard or non-standard signal) and transmit these parameters to the AWG with accuracy. The ease of use supported by this feature not only lowers the learning curve for individuals new to AWG usage but also improves the workflow efficiency for experienced individuals.

- Reduced Size and Power Consumption

The proposed AWG system will feature a compact design and reduced power requirements, increasing its suitability for laboratory benches and teaching environments. This efficient design will support reduction in operating cost and maximized workspace efficiency.

- Cost-Effectiveness

The AWG offers high functionality at a competitive price point compared to other

comparable devices in the market. Its inexpensiveness makes it a more accessible

option for settings such as educational institutions, research labs, and production

environments without a trade-off with performance.

## 5.2. Disadvantages and Limitations

The system is limited to a maximum fundamental frequency of about 100 kHz, which constrains its use to low- and mid-frequency applications. Above this range, our signals could be distorted due to inadequate filtering rates for these higher frequencies. The output amplitude is also capped at ±5 V (10 Vpp) which is around or below the industry standard. Similarly, the generator will only be able to drive 50ohm loads. Any load exceeding this will result in a reduced amplitude, distortion, or clipping.

Other limitations include restricted arbitrary waveform memory, which reduces record length and resolution at higher sample rates, and crosstalk between the two output channels, which is typically −60 to −70 dB but worsens at higher frequencies. In addition, control is handled over Bluetooth, where latency of 10–50 ms and throughput under 300 kbps could lead to potential issues. These factors define the practical operating envelope of the system and distinguish it from higher-end commercial function generators.

## 5.3. Alternatives

One alternative to our design would be using an off-the-shelf commercial function generator, like the ones found in the lab. These instruments provide wide frequency ranges into the MHz, excellent accuracy, and advanced features such as sweeps, modulation, and synchronization. However, they are expensive, bulky, and not customizable, which makes them less suitable for a cost-conscious capstone project where understanding and designing the final project is the whole goal..

Another option would be to use a dedicated DDS function generator IC (such as the AD9833 or AD9850). These chips are compact, inexpensive, and capable of producing clean waveforms into the MHz range with relatively little supporting hardware. The trade-off is that they offer limited flexibility in waveform generation, small waveform memory, and less opportunity for hands-on system-level design.

Finally, a pure microcontroller solution (such as relying only on the ESP32’s DAC and memory) would simplify the hardware significantly and reduce costs. However, this approach is constrained by low DAC resolution, limited memory, and higher waveform distortion, making it unsuitable for applications that demand precision and or a clean output.

## 5.4. Impact

The environmental impact of this project is minimal, as it is a low-power bench top device, though like all electronics it contributes to e-waste if not properly recycled. Its societal impact is positive in providing an affordable educational tool for students and hobbyists, making hands-on electronics more accessible compared to expensive commercial equipment. Ethically, it is important to represent the device honestly, noting its limitations in frequency and accuracy, and to ensure it is safe to use by avoiding hazardous voltage levels and sourcing components responsibly.

Concept of Operations Revision - v1 Arbitrary Waveform Generator
