ssingh-tamu/The-Only-WGT-FinalGIT/Project Deliverables/DEMO SLIDES (Optional)/Mobile Device/Arduino Code Notes.docx

1. Overall behavior: This firmware turns the ESP32 into a BLE receiver that accepts waveform descriptions/data from a phone, rebuilds the waveform, and prints it for plotting over Serial.
2. Phone → ESP32: The phone sends binary packets over a Nordic-UART-style BLE RX characteristic, which the ESP32 parses using a custom TLV protocol.
3. Standard vs ARB: Standard waveforms use simple parameters (shape, frequency, amplitude, etc.), while ARB waveforms send a full sample table with metadata plus many data blocks.
4. Why BLE: BLE gives wireless, phone-friendly communication with low power and no need for cables or Wi-Fi configuration.
5. Why TLV: TLV makes the protocol flexible and self-describing, so new fields can be added without breaking old parsers.
6. Three message types: 0x00 carries standard waveform parameters, 0x01 carries ARB metadata, and 0x02 carries ARB sample data blocks.
7. Fixed 32 bytes: Fixed 32-byte META/standard packets simplify parsing and keep them small enough for reliable BLE transfers.
8. Bounds checking: Every parser checks that i + L and the total length never exceed the buffer size before reading fields.
9. SRC_FULL meaning: SRC_FULL = 65536 defines a virtual full-resolution index space for the ARB waveform, making mapping and decimation math simple.
10. What is g_lut: g_lut is the in-memory lookup table that stores the final decimated Q15 samples of the ARB waveform.
11. What is g_bitmap: g_bitmap tracks which LUT indices have already been filled so we can count unique samples and know completion.
12. Detecting completion: When the number of unique filled entries (g_unique_received) reaches the LUT capacity, the waveform is considered complete and plotted.
13. Decimation math: mapSrcToDst scales the source index into the LUT range using integer math so 65k points are evenly spread into the smaller table.
14. Why min/max: Min/max values provide quick diagnostics of signal range and help verify the ARB data is reasonable.
15. Need for feedAsm: BLE writes can be fragmented or combined, so feedAsm reassembles full logical frames from arbitrary chunks.
16. Role of findHeaderIdx: findHeaderIdx scans for a valid header to resynchronize the parser when bytes are lost or corrupted.
17. Too-large frame: If the computed frame size exceeds g_buf, the code logs “Frame too large” and drops the packet to avoid overflow.
18. DATA before META: If ARB DATA arrives before META, it logs a warning and still assembles blocks, but full context isn’t available until META comes.
19. allocWithFallback decision: It probes PSRAM and DRAM, then tries a list of decreasing capacities until it finds a size it can allocate.
20. PSRAM advantage: PSRAM lets us hold much larger LUTs without exhausting the ESP32’s internal DRAM.
21. Allocation failure: If no allocation works, it logs a fatal message and later ARB operations effectively do nothing because buffers are null.
22. UUID choice: These UUIDs match the Nordic UART Service pattern so existing NUS client tools can talk to the device easily.
23. TX vs RX roles: RX receives binary data from the phone (write), while TX sends text notifications like ACKs or heartbeats back to the phone.
24. ACK purpose: ack:<len> confirms how many bytes were received, letting the phone detect loss or throttling needs.
25. Why BLE2902: The BLE2902 descriptor enables client-side configuration of notifications/indications on the TX characteristic.
26. g_quiet/QPRINT: They allow turning debug prints on or off globally without changing all Serial.print calls.
27. Serial plot output: printArbPlot prints one float per line (with a “wave” label) in a format the Arduino Serial Plotter can graph as a waveform.
28. PLOT_STRIDE effect: PLOT_STRIDE controls how many samples are skipped between printed points, trading resolution for speed and less data.
29. Setup flow: setup() initializes Serial, allocates memory, sets up BLE services/characteristics, starts advertising, and resets the assembler state.
30. HEARTBEAT option: When enabled, loop() periodically sends a “beat” string over TX to show the device is still alive and connected.
31. resetAsm on disconnect: On disconnect it clears any partially assembled frame so the next connection starts with a clean state.
