ssingh-tamu/The-Only-WGT-FinalGIT/Project Deliverables/DEMO SLIDES (Optional)/Mobile Device/Demo Voice Track Notes.docx

# Memo

## Introduction

- Goal
  - Establish a BLE connection between device and ES32 and take in user inputs on standard waveforms or arbitrary waveforms
- To support the goal various testing was done to ensure
  - Connection stability
  - Accurate waveform parameters from app to MCU

## Features

- Connection Page
  - Powered by bluefy, a BLE enabled search engine
  - Leverages webapp implementation for cross compatibility
  - Finds and connects to advertising ESP32s
- Standard Waveform Page
  - Sine, Square, Sinc, and Triangle standard waveforms available
  - Frequency, Offset, VPP, and Phase adjustable
  - Channel Selection and Preview Screen
  - Built in user limitations
  - Sends parameters as a HEX String for MCU to construct
- Drawable Tab
  - Allows user to draw one period of an arbitrary waveform using their finger
  - Built in user limitations to reduce the likelihood of forbidden waveforms
- Waveform Editor Tab
  - Adjustable Gain, DC Offset, and Phase
  - Adjustable Frequency, Vpp, and Channel selection
  - Ability to upload/download waveform packets
  - Preview Screen for usability

## Send Waveform and Reconstruction Preview

- Send waveform
  - Notice packets being received by ESP32
    - This process will take about 2 minutes to complete
  - Note, since the user draws one period of the waveform, the ESP32 will also receive a line of data (similar to the standard waveform) with the parameters for rebuilding the waveform later
    - Includes Frequency
    - Vpp
    - Channel
  - The ESP32 will rebuilt these packets and I will plot them in excel to see that waveform on the app matches the waveform that was reconstructed.

403 Demo Script: Serene Singh
