ssingh-tamu/The-Only-WGT-FinalGIT/Research/Communication.docx

FPGA (Verilog) → Software (Dart)

- Using Rapid Open Hardware Development (ROHD (https://pub.dev/packages/rohd))
- Documentation:
  - https://intel.github.io/rohd-website/docs/sample-example/
  - https://intel.github.io/rohd/rohd/
