ssingh-tamu/The-Only-WGT-FinalGIT/Dev Images.docx

Version 1: Setting up emulator and trying out buttons

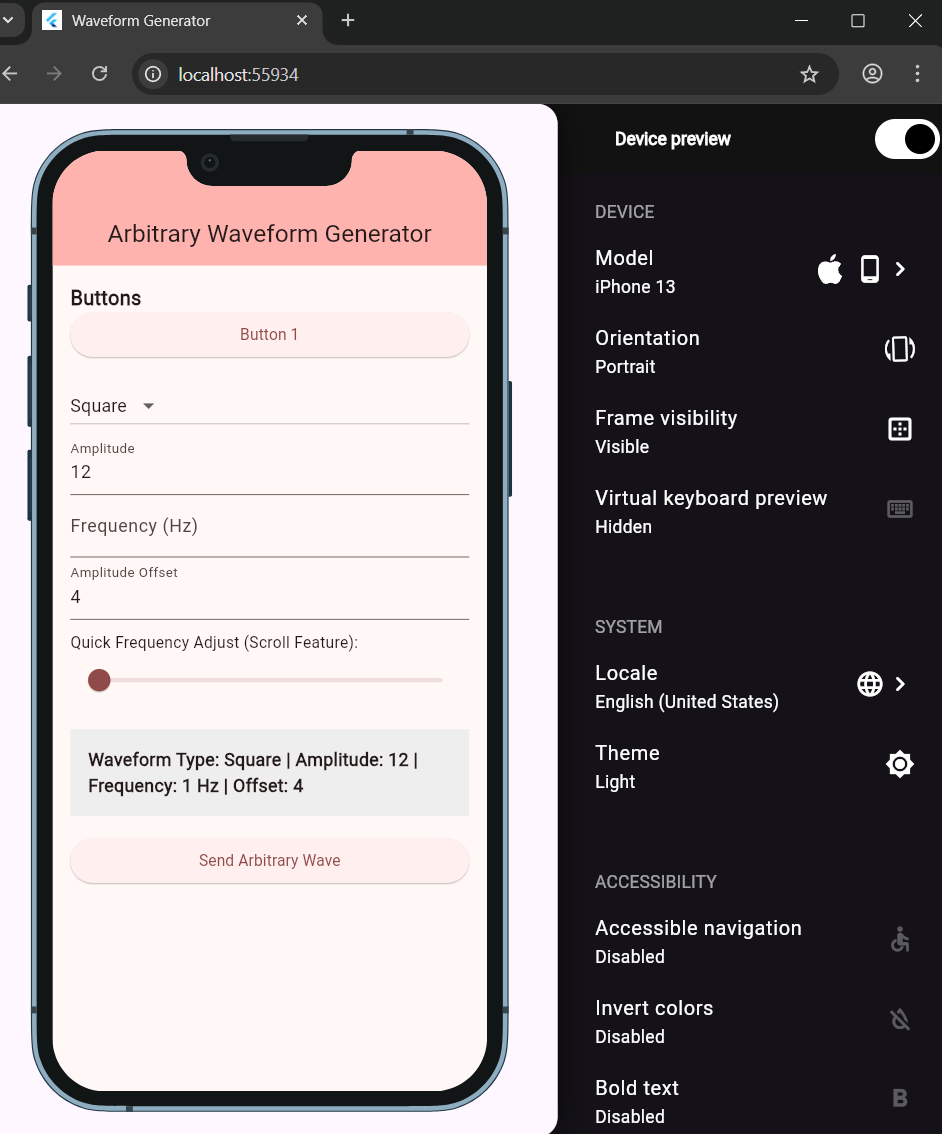
[picture p25: figure]

Version 2: Made a cleaner UI, and attempted to start implementing features

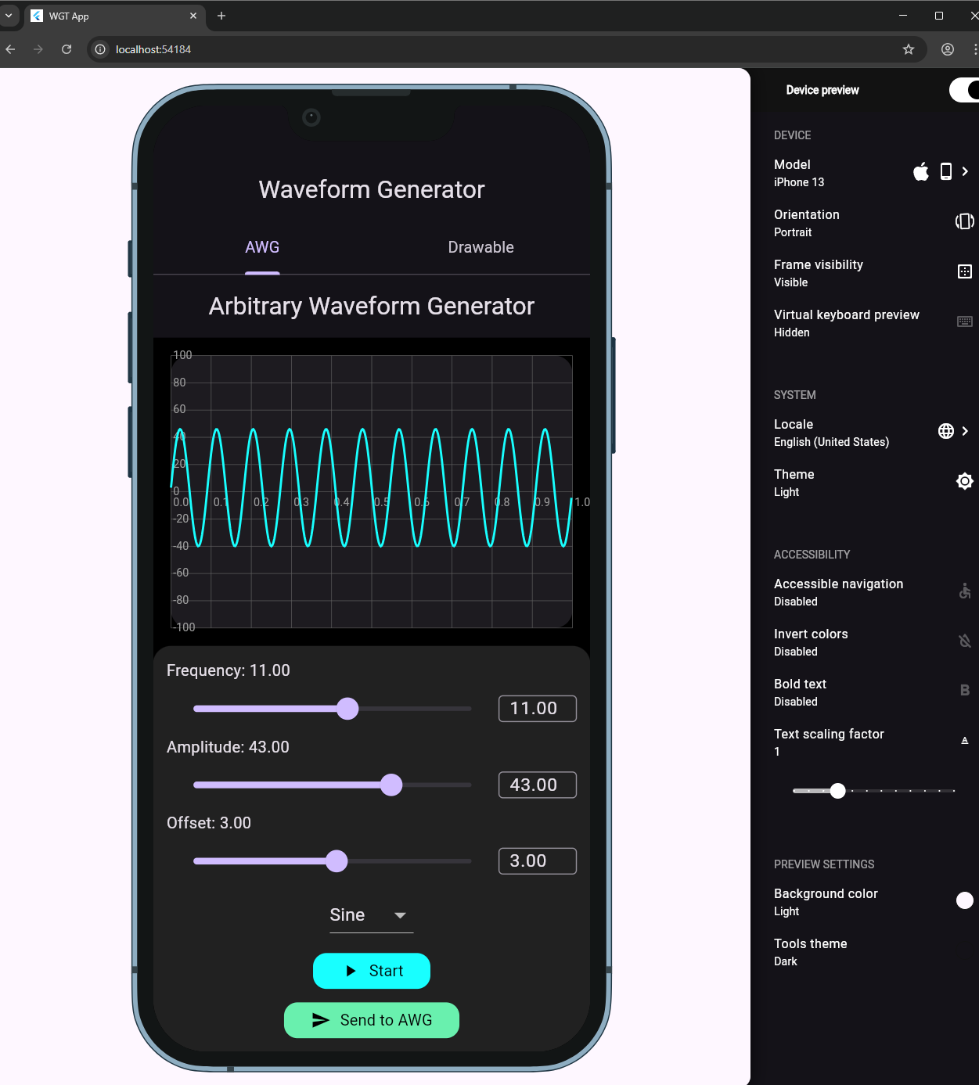
[picture p26: figure]
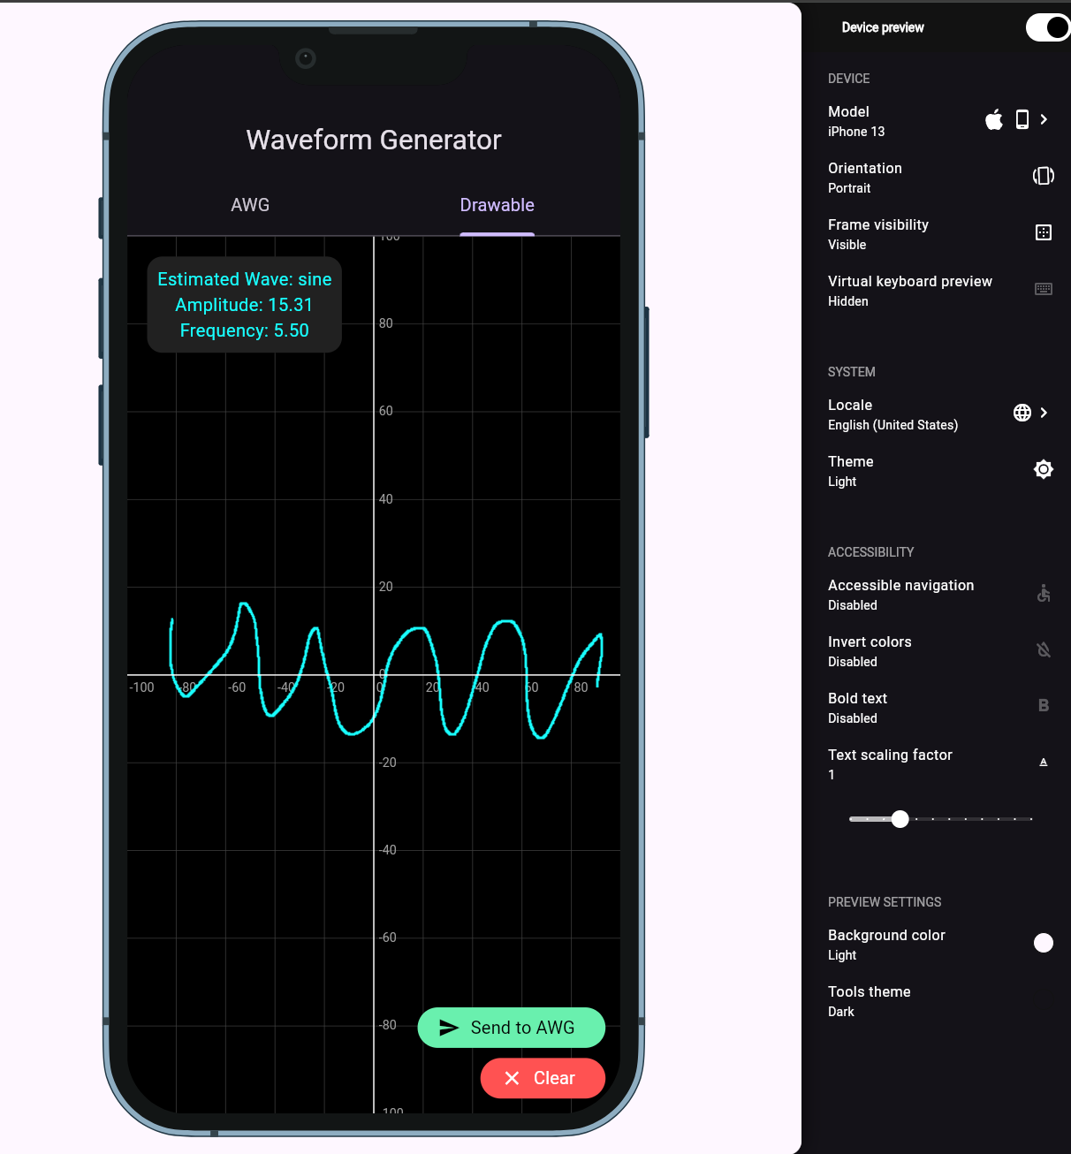
[picture p27: figure]

Version 3: Added MCU Connection page

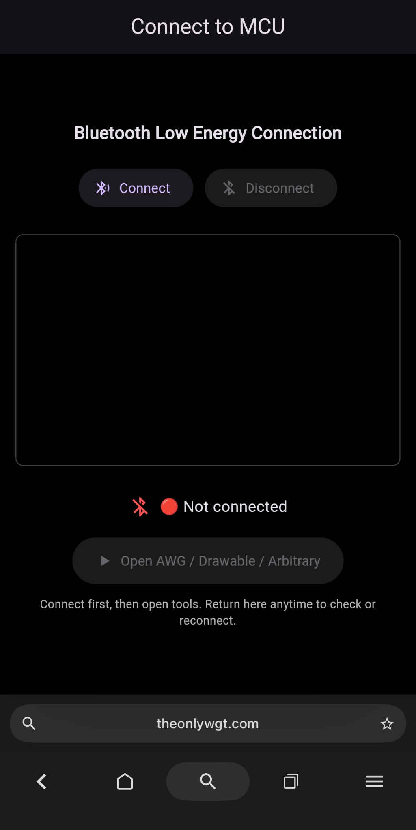
[picture p28: figure]
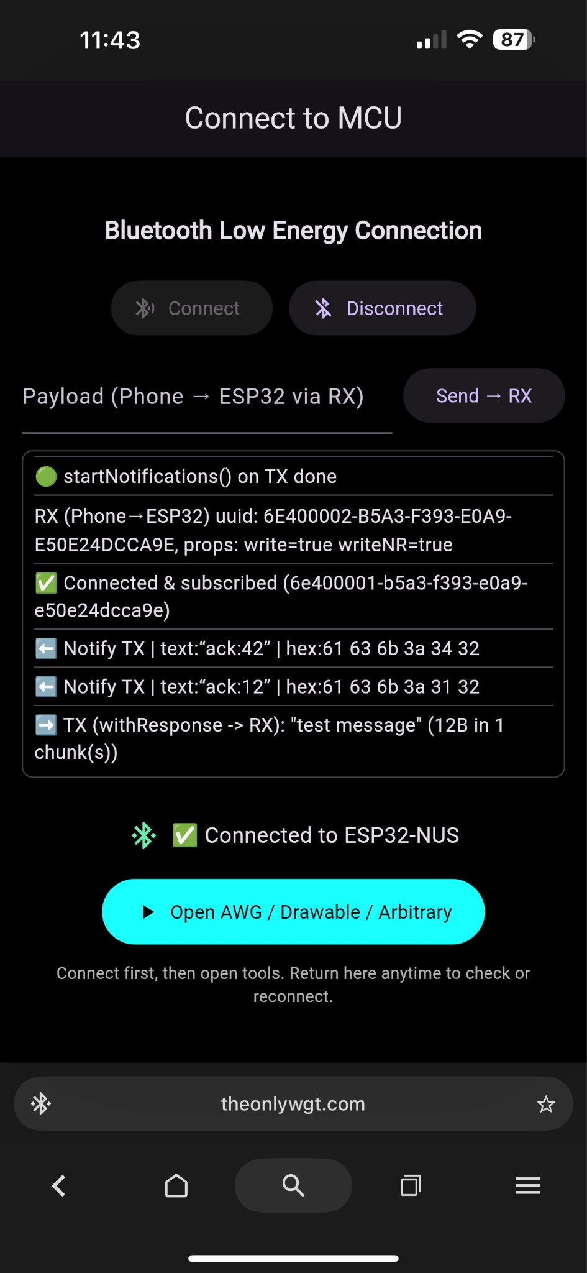
[picture p29: figure]

Version 4: Added New Arbitrary waveform tab to supplement Drawable waveform

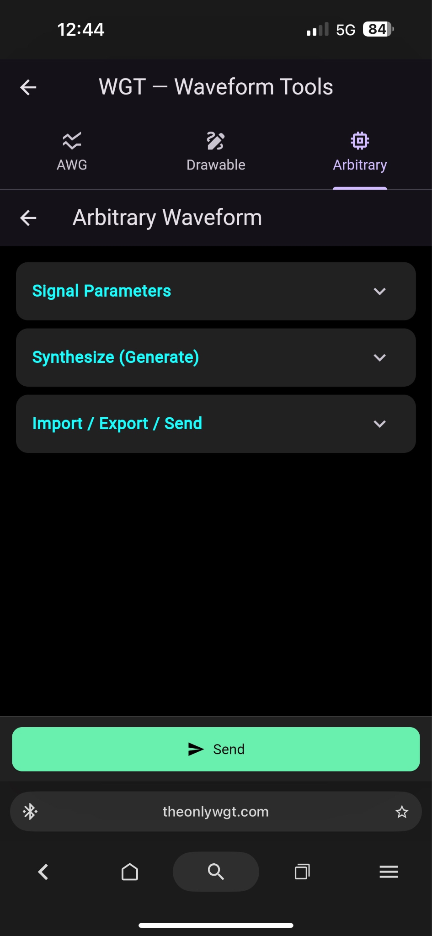
[picture p30: figure]
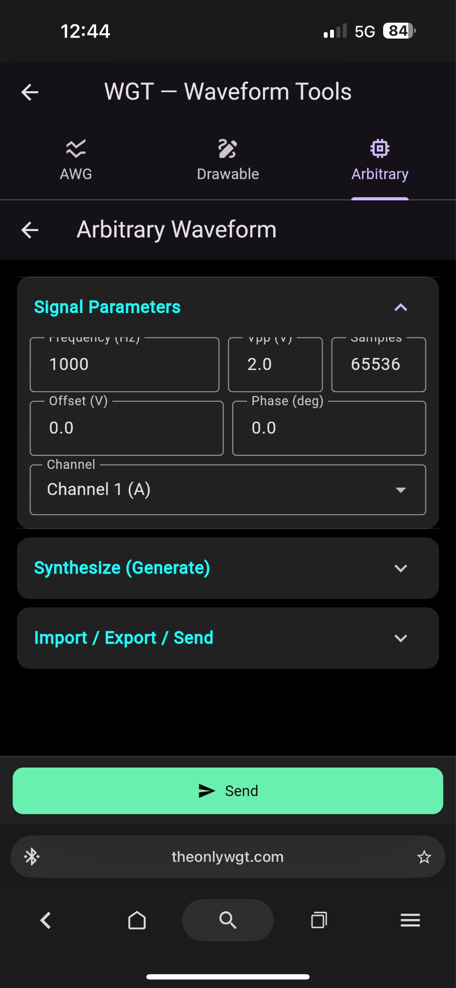
[picture p31: figure]
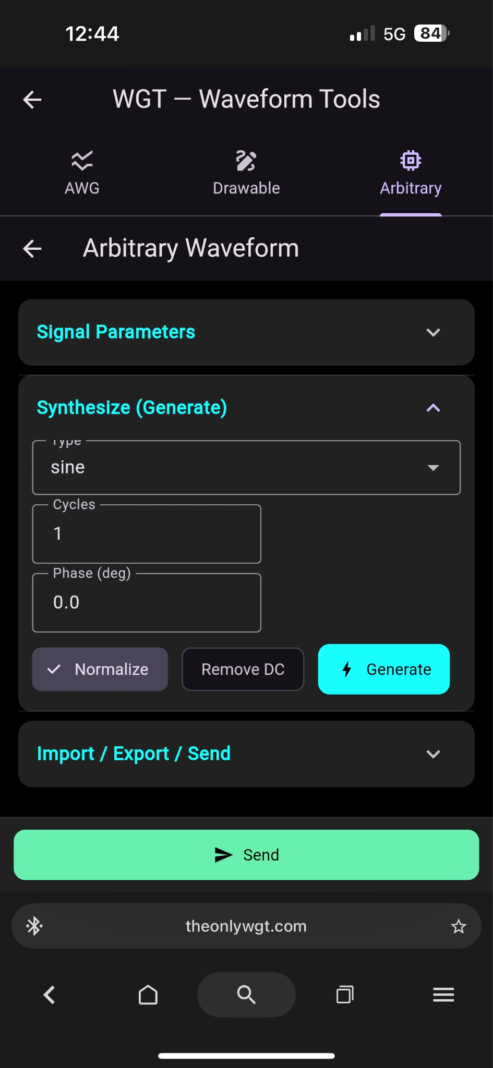
[picture p32: figure]
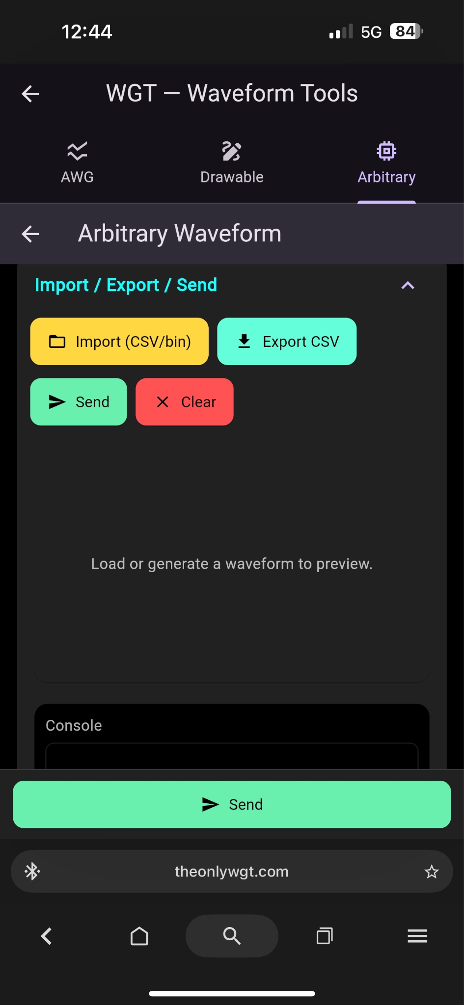
[picture p33: figure]
