ssingh-tamu/The-Only-WGT-FinalGIT/Meeting Notes/9_30 Meeting Notes.docx

To Do:

1. Do Presentation Dry Run
2. Start/Assign FSR, Validation Plan,

The following items were purchased

Transaction | Date | Quantity | Cost | Status | Comments | Name + Links
DAC/Microcontrollers | 9/30 | 2 | $55.49 | Pending | Purchased 9/30 | https://www.mouser.com/ProductDetail/595-DAC8820IBDB

Mobile/Enclosure | 9/30 | 2 | $11.00 | Pending | Purchased 9/30 | 343-CONBNC002-ND (https://www.digikey.com/en/products/detail/te-connectivity-linx/CONBNC002/16013841)
