ssingh-tamu/The-Only-WGT-FinalGIT/Research/Mobile Devices + Communications.docx

Anticipated Purchasing List with Estimated Cost:

- Communication Equipment [FIX ME]

Major Deliverables and Deadlines:

- List of wanted features
- Finalize Features
- Finalize Front End Design
- Create/Incrementally Test features
- Finalize App Frontend/Back
- Test functionality of app

Concepts Designs/Ideas for Layout:

- Front End Design:
- Preset Waveforms
  - Square
  - Triangle
  - Sin
- Amplitude input
- Frequency Input
- Numeric Scroll Feature
- Auto Updating Waveform Visual
- ‘Send Arbitrary Wave’ button
- Amplitude offset input
- Backend Design
- Calculating Waveform with Amplitude/Frequency– LOOK INTO SPEED
- Communication Interfacing
  - [FIX ME]

Ideal Implementation Approach:

App Development: ____pros/cons____

Commination Interface: ___pros/cons___
