ssingh-tamu/The-Only-WGT-FinalGIT/AppImage.png

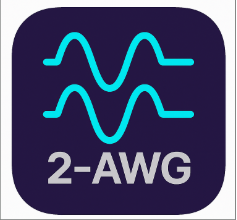
AppImage.png
