ssingh-tamu/The-Only-WGT-FinalGIT/FPGA and Memory/freqclock.png

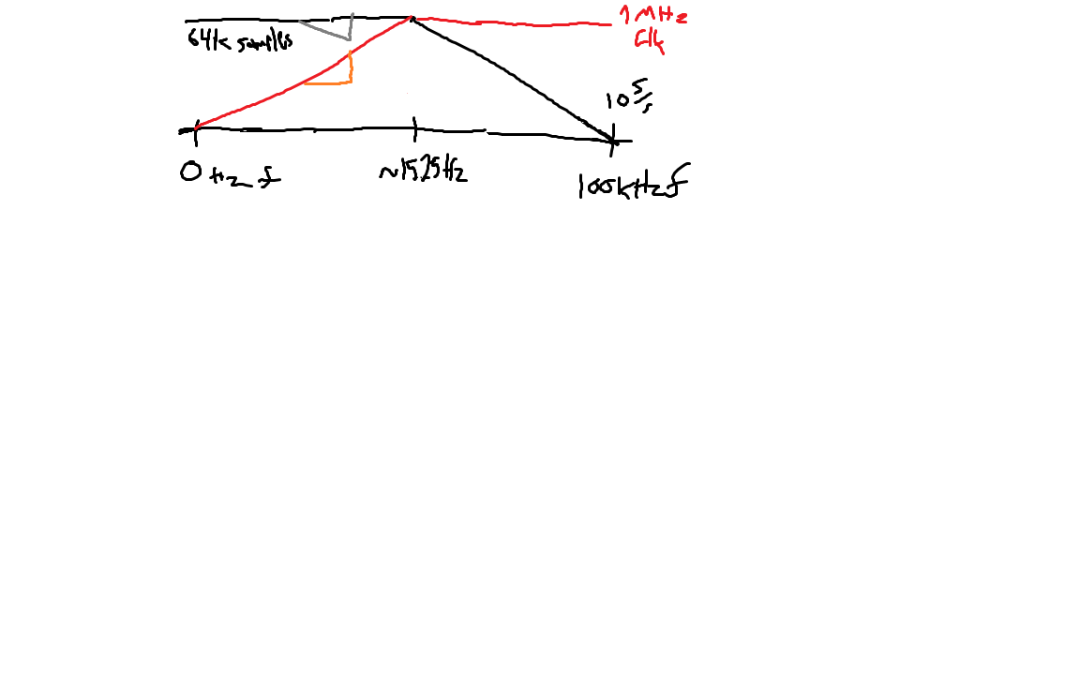
FPGA and Memory/freqclock.png
