ssingh-tamu/The-Only-WGT-FinalGIT/FPGA and Memory/Purchase Requests/PCB Purchase Request.xlsx

Transaction | Date | Quantity | Cost | Status | Links
Power Terminal Block | 2025-10-28 | 1 | $0.36 | Not Purchased | https://www.digikey.com/en/products/detail/w%C3%BCrth-elektronik/691137710002/6644051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..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
6 Pin Header (SPI) | 2025-10-28 | 1 | $0.30 | Not Purchased | https://www.digikey.com/en/products/detail/w%C3%BCrth-elektronik/62000621121/15672227
10 Pin Header (JTAG) | 2025-10-28 | 1 | $0.43 | Not Purchased | https://www.digikey.com/en/products/detail/w%C3%BCrth-elektronik/61201021621/2060590
18 Pin Header (Data Out) | 2025-10-28 | 2 | $2.16 | Not Purchased | https://www.digikey.com/en/products/detail/molex/0901301118/760951
330Ω Resistor | 2025-10-28 | 10 | $0.01 | Not Purchased | https://www.digikey.com/en/products/detail/yageo/RC0603JR-07330RL/726769
1kΩ Resistor | 2025-10-28 | 10 | $0.01 | Not Purchased | https://www.digikey.com/en/products/detail/stackpole-electronics-inc/RMCF0603FT1K00/1761077
10kΩ Resistor | 2025-10-28 | 25 | $0.01 | Not Purchased | https://www.digikey.com/en/products/detail/yageo/RC0603FR-0710KL/726880
LED | 2025-10-28 | 6 | $0.39 | Not Purchased | https://www.digikey.com/en/products/detail/everlight-electronics-co-ltd/QTLP650CRTR/2675907
Schottky Diode | 2025-10-28 | 10 | $0.15 | Not Purchased | https://www.digikey.com/en/products/detail/bourns-inc/CD0603-B0340R/7796828
10pF Capacitor | 2025-10-28 | 10 | $0.07 | Not Purchased | https://www.digikey.com/en/products/detail/kemet/C0603C100J5GACTU/411051
0.01uF Capacitor | 2025-10-28 | 10 | $0.01 | Not Purchased | https://www.digikey.com/en/products/detail/kemet/C0603C103K5RACTU/411090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
0.1uF Capacitor | 2025-10-28 | 46 | $0.01 | Not Purchased | https://www.digikey.com/en/products/detail/yageo/CC0603KRX7R7BB104/302822
10uF Capacitor | 2025-10-28 | 14 | $0.12 | Not Purchased | https://www.digikey.com/en/products/detail/yageo/CC0603KRX5R6BB106/5195191
100 MHz Oscillator | 2025-10-28 | 1 | $2.70 | Not Purchased | https://www.digikey.com/en/products/detail/abracon-llc/ASEM1-100-000MHZ-LC-T/1873223?gclsrc=aw.ds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
Total |  |  | $14.92
Total + Tax + Shipping |  |  | $21.97
Available Budget |  |  | $355.06
Budget Remaining |  |  | $333.09
 |  | https://www.digikey.com/short/52f3775d
