ssingh-tamu/The-Only-WGT-FinalGIT/Finance/Budget.xlsx

Sheet: Sheet1
MONTH/YEAR
INCOME |  |  |  | BUDGET |  |  |  |  | PURCHASES
Income Source | Date | Income | Notes | Monthly Expenses | Planned | Actual | Difference | Notes | Transaction | Date | Quantity | Cost | Status | Comments | Name + Links
Serene Singh |  | $125.00 |  | Mobile/Enclosure |  | $4.05 | -$4.05 |  | DAC/Microcontrollers | 2025-09-23 | 2 | $23.75 | Pending |  | 2 TI DAC8820 (https://www.mouser.com/ProductDetail/Texas-Instruments/DAC8820IBDB?qs=rNOSrj6uCs0DMtzg30wQrA%3D%3D)
Joe Knipper |  | $125.00 |  | DAC/Microcontrollers |  | $39.75 | -$39.75 |  | Mobile/Enclosure |  | 2 | $2.00 | Not Purchased | LED Panel Mount Indicators LED SNAPIN PAN IND | 645-559-2201-003F (https://www.mouser.com/ProductDetail/Dialight/559-2201-003F)
Brayden Donovan |  | $125.00 |  | Power/Filter |  | $410.38 | -$410.38 |  | Mobile/Enclosure | 2025-09-23 | 2 | $2.05 | Pending |  | 343-CONBNC002-ND (https://www.digikey.com/en/products/detail/te-connectivity-linx/CONBNC002/16013841)
 |  |  |  |  |  |  |  |  | DAC/Microcontrollers |  | 1 | $8.00 | Not Purchased |  | OPA2140 (https://www.mouser.com/ProductDetail/Texas-Instruments/OPA2140AID?qs=1WmUhT%2FVMIPYSL%2F7pjMJOQ%3D%3D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)
Team Member 4 |  | $125.00 |  | FPGA |  | $65.74 | -$65.74 |  | DAC/Microcontrollers |  | 1 | $8.00 | Not Purchased |  | OPA1612 (https://www.mouser.com/ProductDetail/Texas-Instruments/OPA1612AID?qs=6805eV47HhZ33ht61fXkkg%3D%3D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)
Total |  | $500.00 |  | Other |  | $0.00 | $0.00 |  | Power/Filter |  | 1 |  | Not Purchased | (may need more for testing and caution) | DC Power Jack: 694106301002 (https://www.mouser.com/ProductDetail/Wurth-Elektronik/694106301002?qs=a9WhcLg8qCwOEkcI62k5mA%3D%3D)
 |  |  |  |  | $0.00 | $519.92 |  |  | Power/Filter |  | 1 |  | Not Purchased |  | 2A Fuse: 0408002.WR (https://www.mouser.com/ProductDetail/Littelfuse/0408002.WR)
 |  |  |  |  |  |  |  |  | Power/Filter |  | 1 |  | Not Purchased |  | P-Channel Mosfet for RPT: AO3401A (https://www.digikey.com/en/products/detail/alpha-omega-semiconductor-inc/AO3401A/1855773)
 |  |  |  |  |  |  |  |  | Power/Filter |  | 1 |  | Not Purchased |  | TVS: SMBJ15A (https://www.digikey.com/en/products/detail/littelfuse-inc/SMBJ15A/285980?gclsrc=aw.ds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)
 |  |  |  |  |  |  |  |  | Power/Filter |  | 10 |  | Not Purchased |  | 220 uF Bulk + Decoupling: 865230457007 (https://www.mouser.com/ProductDetail/Wurth-Elektronik/865230457007)
 |  |  |  |  |  |  |  |  | Power/Filter |  | 1 |  | Not Purchased |  | Current sense resistor: WSLP2512R0100FEA (https://www.digikey.com/en/products/detail/vishay-dale/WSLP2512R0100FEA/9758426)
 |  |  |  |  |  |  |  |  | Power/Filter |  | 1 |  | Not Purchased |  | Power/current monitor IC: INA219AIDR (https://www.mouser.com/ProductDetail/Texas-Instruments/INA219AIDR?qs=XGzIaZb%2FFYIE5YcOHTnKDA%3D%3D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)
 |  |  |  |  |  |  |  |  | Power/Filter |  | 1 |  | Not Purchased |  | Buck Converter: MIC26903YJL-TR (https://www.digikey.com/en/products/detail/microchip-technology/MIC26903YJL-TR/2747223)
 |  |  |  |  |  |  |  |  | Power/Filter |  |  |  | Not Purchased |  | Buck External Parts
 |  |  |  |  |  |  |  |  | Power/Filter |  | 1 |  | Not Purchased |  | LDO: LT1763CS8-3.3#PBF (https://www.digikey.com/en/products/detail/analog-devices-inc/LT1763CS8-3-3-PBF/891881?gclsrc=aw.ds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)
 |  |  |  |  |  |  |  |  | Power/Filter |  | 1 |  | Not Purchased |  | Inverter for output voltage: LM27761DSGT (https://www.digikey.com/en/products/detail/texas-instruments/LM27761DSGT/5880550)
 |  |  |  |  |  |  |  |  | Power/Filter |  |  |  | Not Purchased |  | Inverter External Parts
 |  |  |  |  |  |  |  |  | Power/Filter |  |  |  | Not Purchased |  | Output indicator LEDs
 |  |  |  |  |  |  |  |  | Power/Filter |  |  | $11.29 | Not Purchased | Filtering below: check | VREF: LTC6655-2.5 (https://www.digikey.com/en/products/detail/analog-devices-inc/LTC6655CHMS8-5-PBF/2217113)
 |  |  |  |  |  |  |  |  | Power/Filter |  |  | $10.77 | Not Purchased |  | DAC output buffer/bipolarizer: OPA827 (https://www.digikey.com/en/products/detail/texas-instruments/OPA827AIDGKR/2232416)
 |  |  |  |  |  |  |  |  | Power/Filter |  |  | $7.38 | Not Purchased |  | Reconstruction Filter op-amps: ADA4899-1 (https://www.digikey.com/en/products/detail/analog-devices-inc/ADA4899-1YRDZ-R7/1199772)
 |  |  |  |  |  |  |  |  | Power/Filter |  |  | $9.44 | Not Purchased |  | VGA/PGA: ADG1411 (https://www.digikey.com/en/products/detail/analog-devices-inc/ADG1411YCPZ-REEL7/1972285)
 |  |  |  |  |  |  |  |  | Power/Filter |  |  | $7.07 | Not Purchased |  | Offset Summing Amplifier: OPA2140 (https://www.digikey.com/en/products/detail/texas-instruments/OPA2140AIDR/2597282)
 |  |  |  |  |  |  |  |  | Power/Filter |  |  | $11.16 | Not Purchased |  | Output buffer/line driver to drive 50 Ohm loads: THS3091 (https://www.mouser.com/ProductDetail/Texas-Instruments/THS3091IDGNR?qs=OcgtsXO%252B3guzZnsCfpKFjQ%3D%3D)
 |  |  |  |  |  |  |  |  | Power/Filter |  |  |  | Not Purchased |  | Passive & Protection Components
 |  |  |  |  |  |  |  |  | FPGA | 2025-10-01 | 1 | $32.87 | Purchased |  | 10M08 FPGA (https://www.digikey.com/en/products/detail/altera/10M08SCE144I7G/5044245)
 |  |  |  |  |  |  |  |  | FPGA | 2025-10-01 | 2 | $2.51 | Purchased |  | 128k SRAM (https://www.digikey.com/en/products/detail/issi-integrated-silicon-solution-inc/IS62WV12816BLL-55TLI/1555418)
 |  |  |  |  |  |  |  |  | FPGA | 2025-10-07 | 2 | $8.39 | Purchased |  | TSOP-44(II) to DIP-44 SMT Adapter (https://www.mouser.com/ProductDetail/Chip-Quik/PA0217?qs=gjT6naH6P5LpZVyGXd9trw%3D%3D)
 |  |  |  |  |  |  |  |  | FPGA | 2025-10-30 | 1 | $21.97 | Purchased |  | FPGA PCB Components (https://www.digikey.com/short/52f3775d)
 |  |  |  |  |  |  |  |  | FPGA
 |  |  |  |  |  |  |  |  | Power/Filter | 2025-10-16 |  | $259.30 | Purchased |  | General Power/Filter Order, includes Tariffs and Tax
 |  |  |  |  |  |  |  |  | Power/Filter | 2025-10-26 |  | $80.55 | Purchased |  | General Power/Filter Order, includes Tariffs and Tax
 |  |  |  |  |  |  |  |  | Power/Filter | 2025-10-27 |  | $12.07 | Purchased |  | General Power/Filter Order, includes Tariffs and Tax
 |  |  |  |  |  |  |  |  | Power/Filter | 2025-10-31 |  | $1.35 | Purchased |  | General Power/Filter Order, includes Tariffs and Tax

Sheet: Sheet2
BNC Jack
Type: 50 Ω BNC jack
Frequency rating: At least 100 MHz (well above your 100 kHz output)
Voltage rating: ≥100 V (your ±5 V is trivial)
Style: Right-angle PCB mount (if the board is enclosure-aligned) or panel-mount bulkhead (with short coax if offset)
