ssingh-tamu/The-Only-WGT-FinalGIT/FPGA and Memory/Purchase Requests/FPGA Purchases 10_7.xlsx

Transaction | Date | Quantity | Cost | Status | Links
10M08 FPGA | 2025-10-07 | 1 | $32.87 | Not Purchased | https://www.digikey.com/en/products/detail/altera/10M08SCE144I7G/5044245
128k SRAM | 2025-10-07 | 2 | $2.51 | Not Purchased | https://www.digikey.com/en/products/detail/issi-integrated-silicon-solution-inc/IS62WV12816BLL-55TLI/1555418
TSOP-44(II) to DIP-44 SMT Adapter | 2025-10-07 | 2 | $8.39 | Not Purchased | https://www.mouser.com/ProductDetail/Chip-Quik/PA0217?qs=gjT6naH6P5LpZVyGXd9trw%3D%3D
Total |  |  | $54.67
Available Budget |  |  | $448.40
Budget Remaining |  |  | $393.73
