ssingh-tamu/The-Only-WGT-FinalGIT/Finance/9_30.xlsx

Transaction | Date | Quantity | Cost | Status | Comments | Name + Links
DAC/Microcontrollers | 2025-09-30 | 2 | $55.49 | Pending | Purchased 9/30 | https://www.mouser.com/ProductDetail/595-DAC8820IBDB
