ssingh-tamu/The-Only-WGT-FinalGIT/PCB/ESP32_Schematic.pdf

# ESP32

# POWER

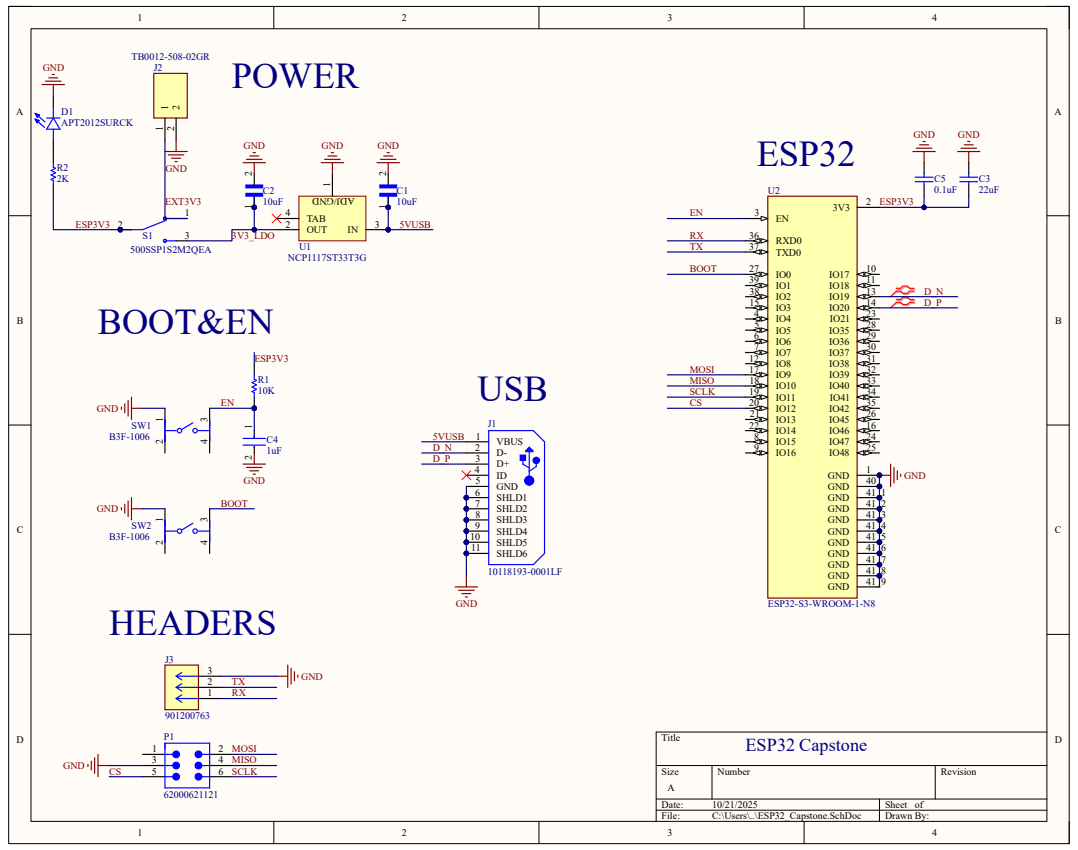
[picture p39: page 1]
