ssingh-tamu/The-Only-WGT-FinalGIT/FPGA and Memory/MAX10 Documentation/jtag documentation.pdf

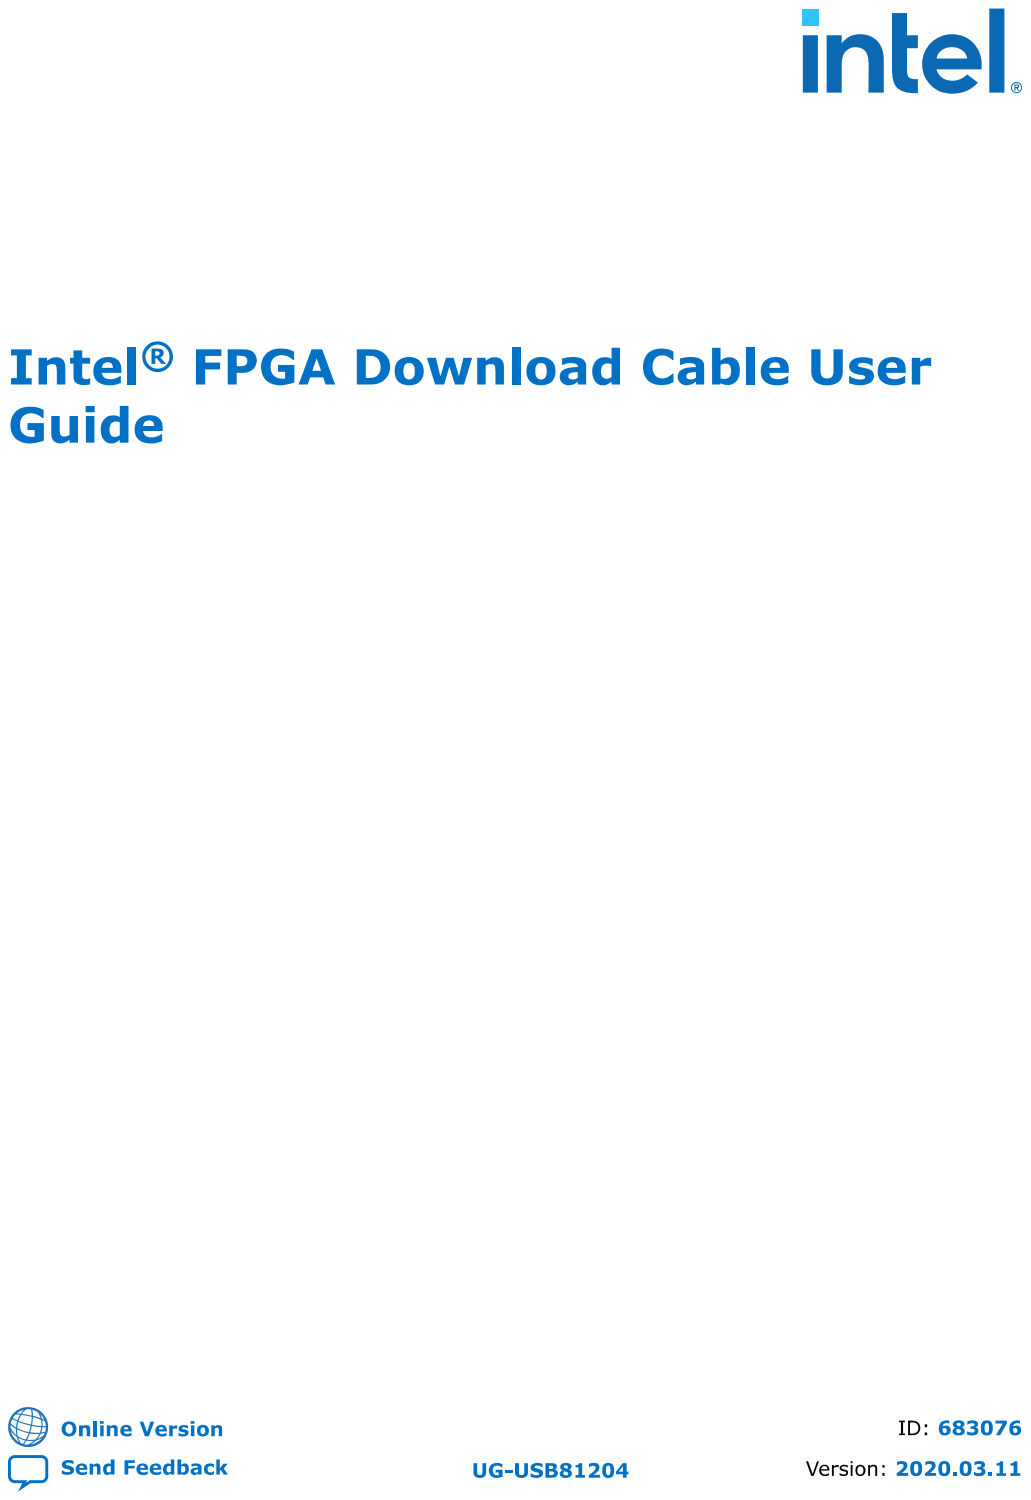
[picture p40: page 1]

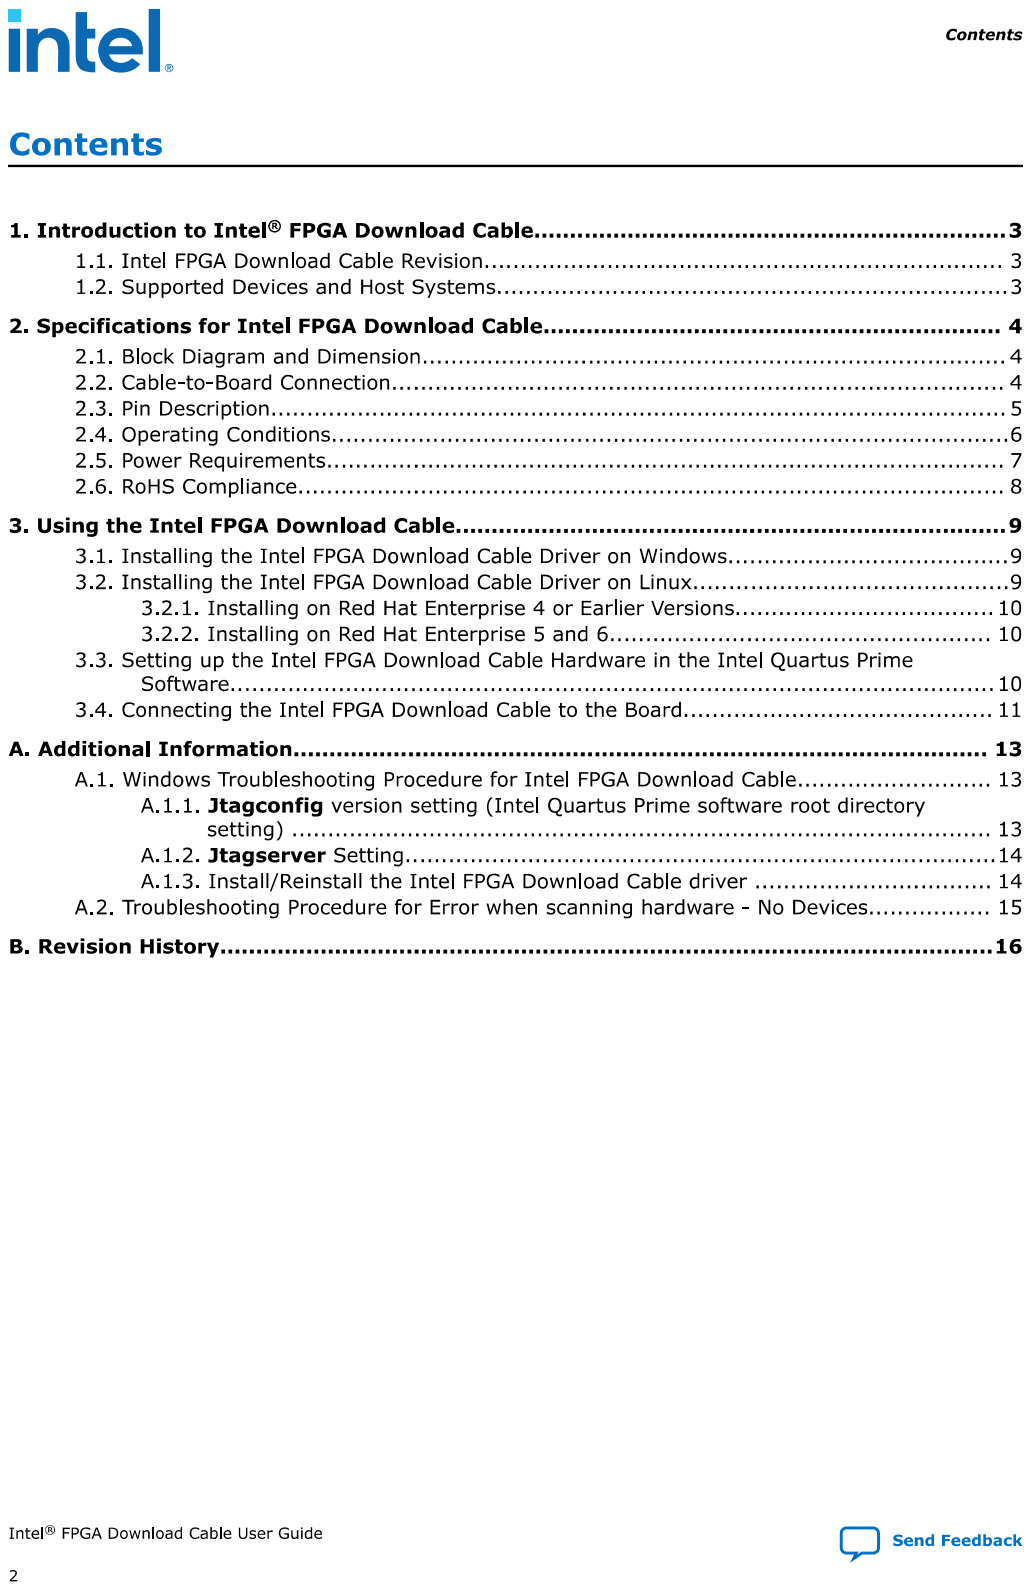
[picture p41: page 2]

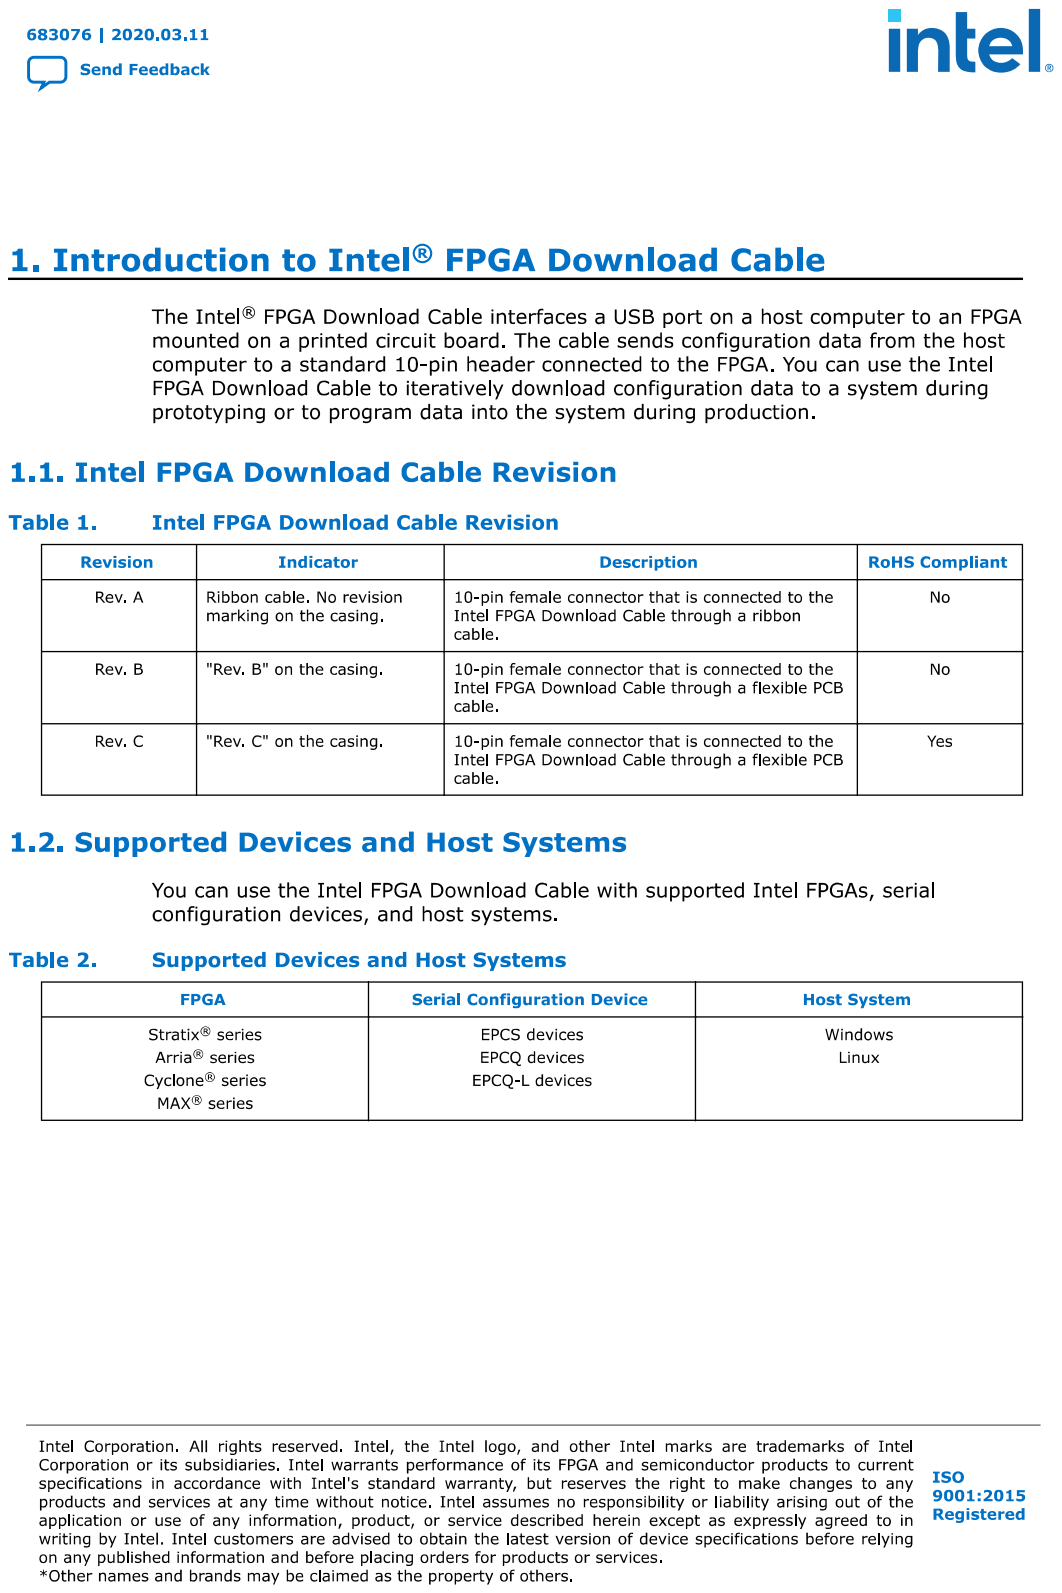
[picture p42: page 3]

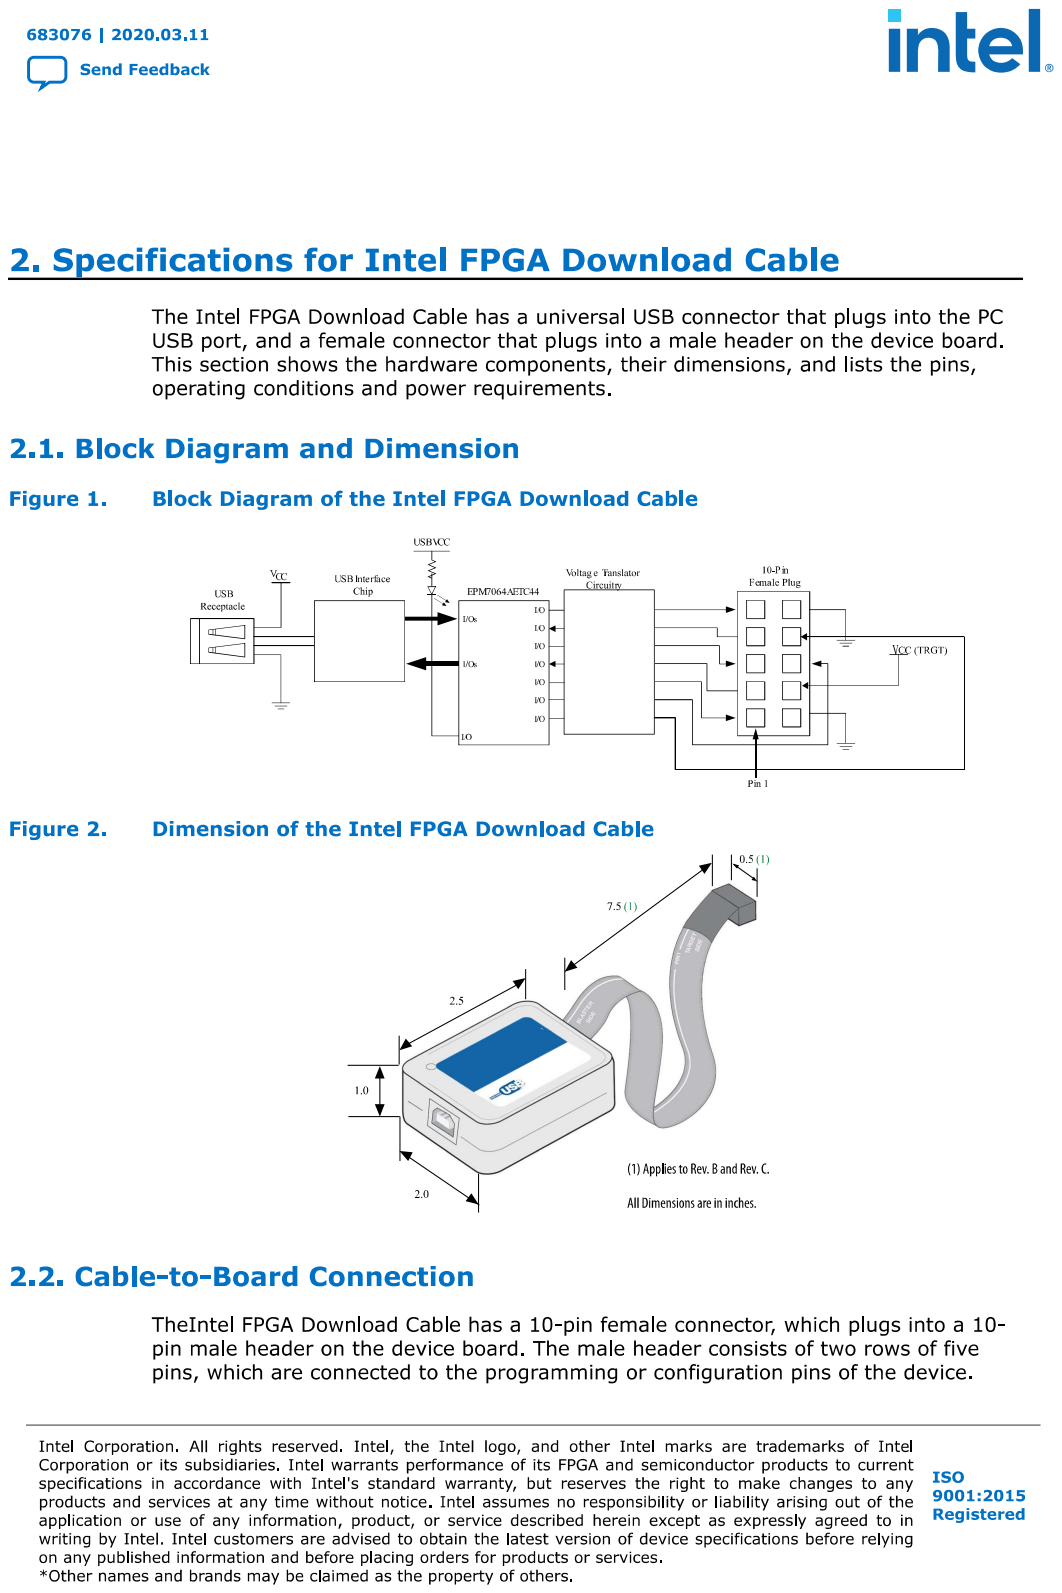
[picture p43: page 4]

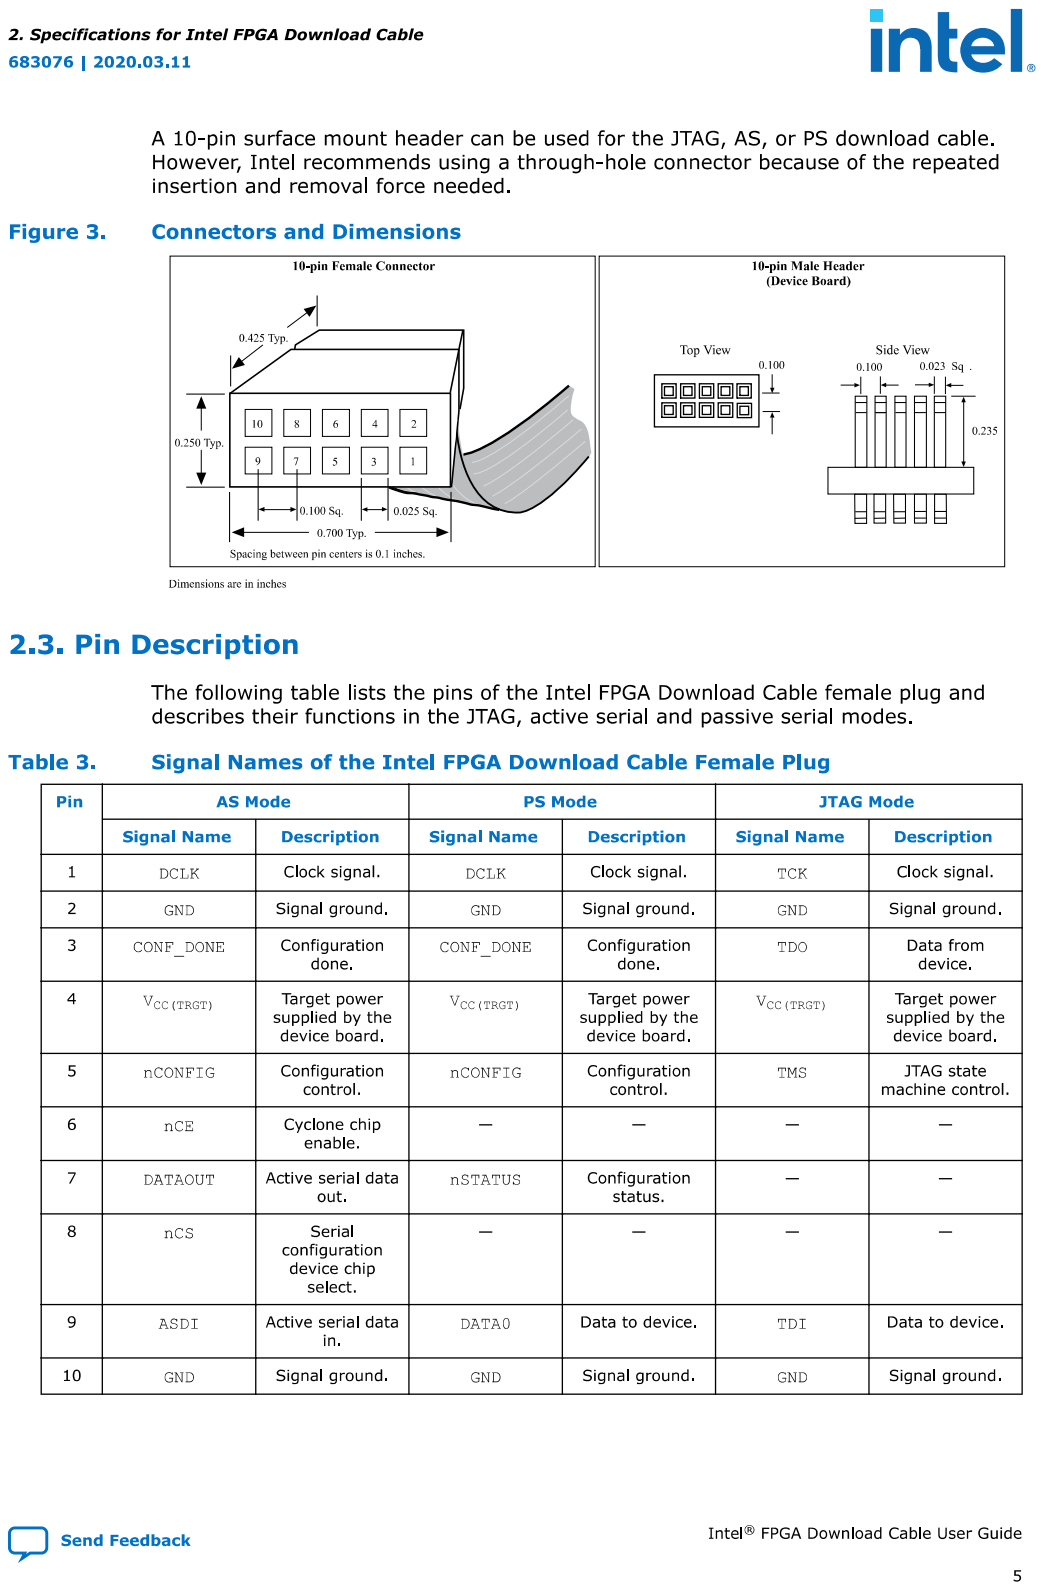
[picture p44: page 5]

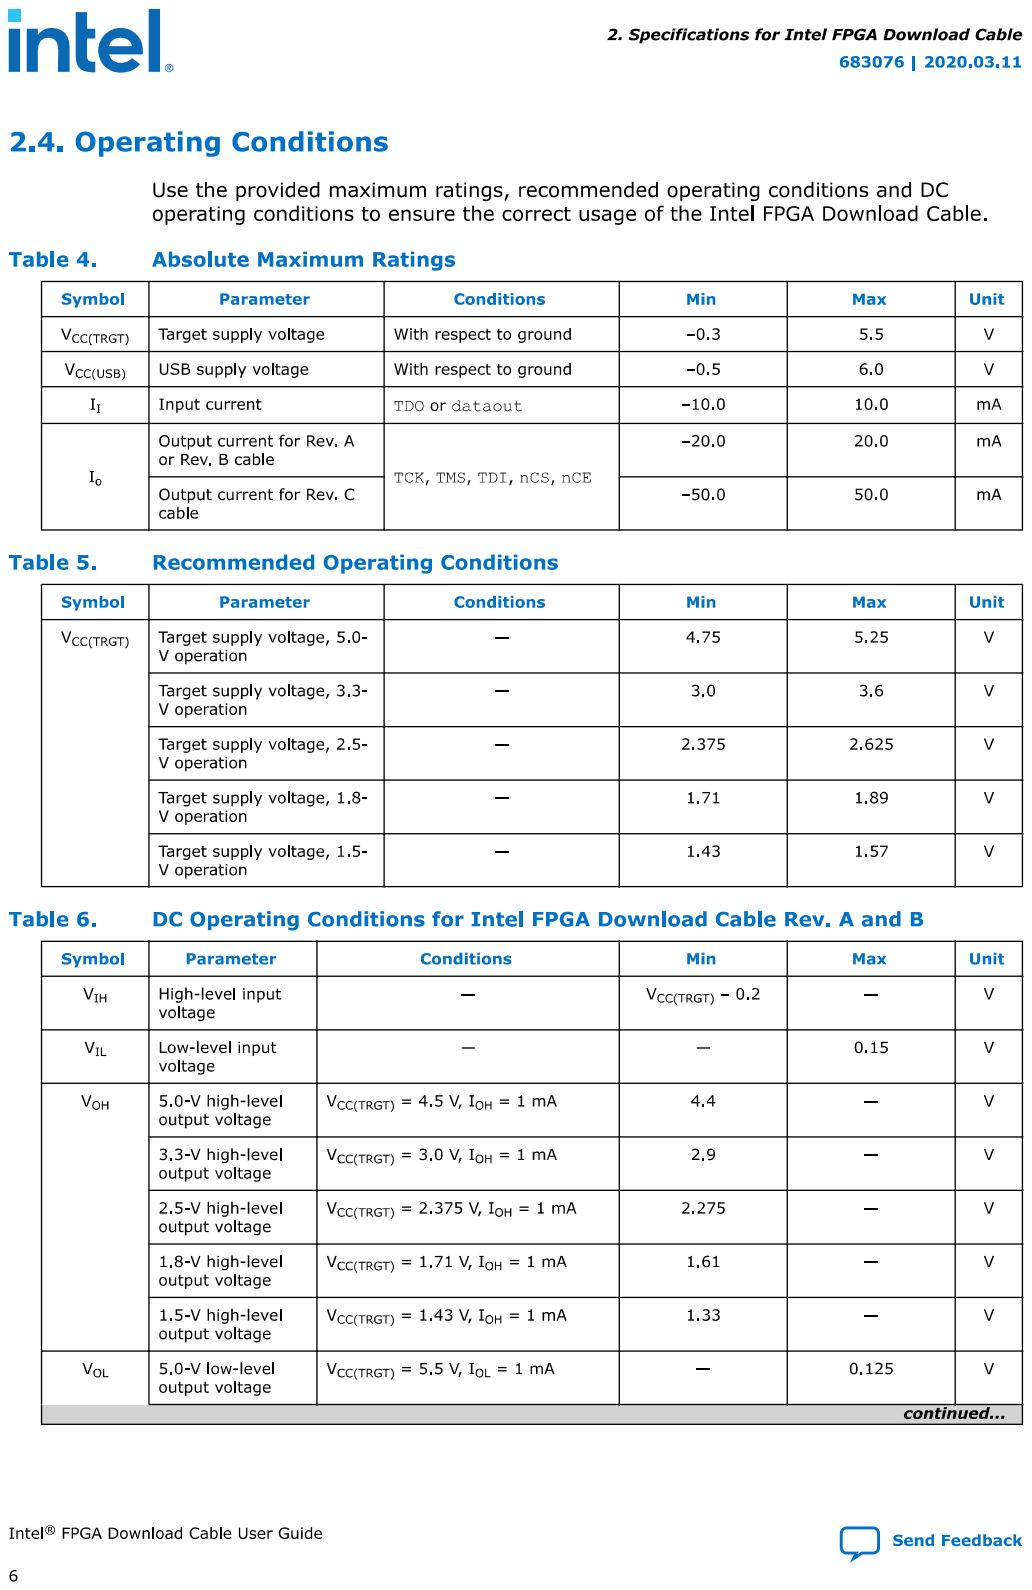
[picture p45: page 6]

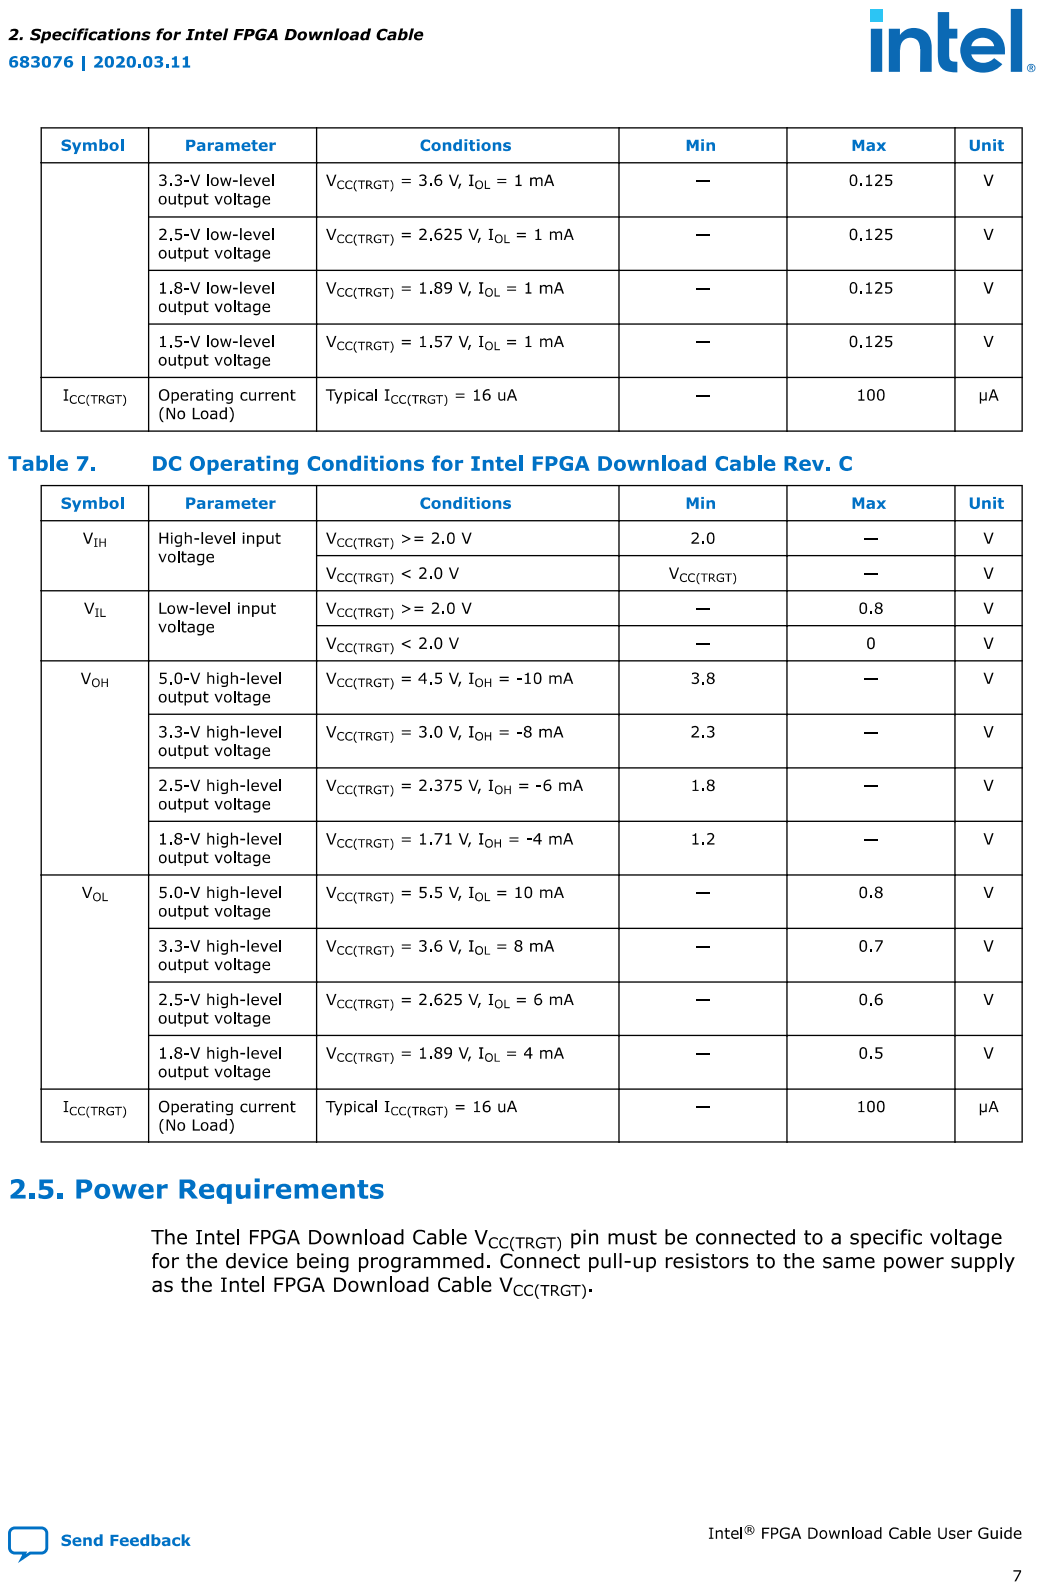
[picture p46: page 7]

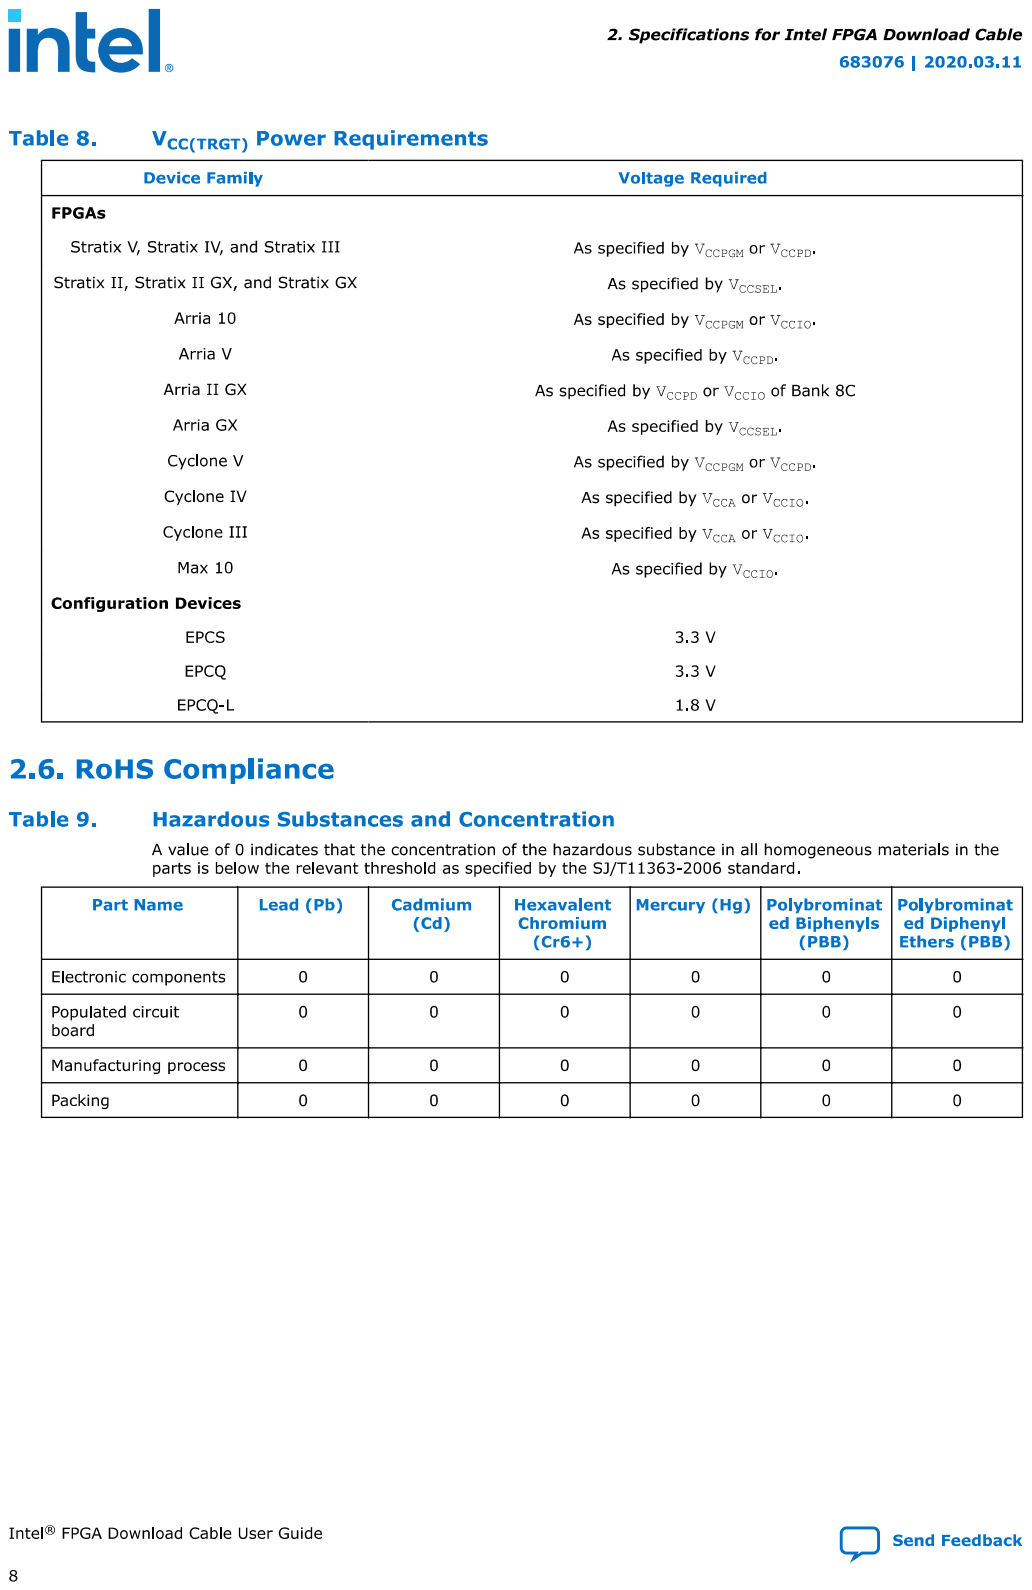
[picture p47: page 8]

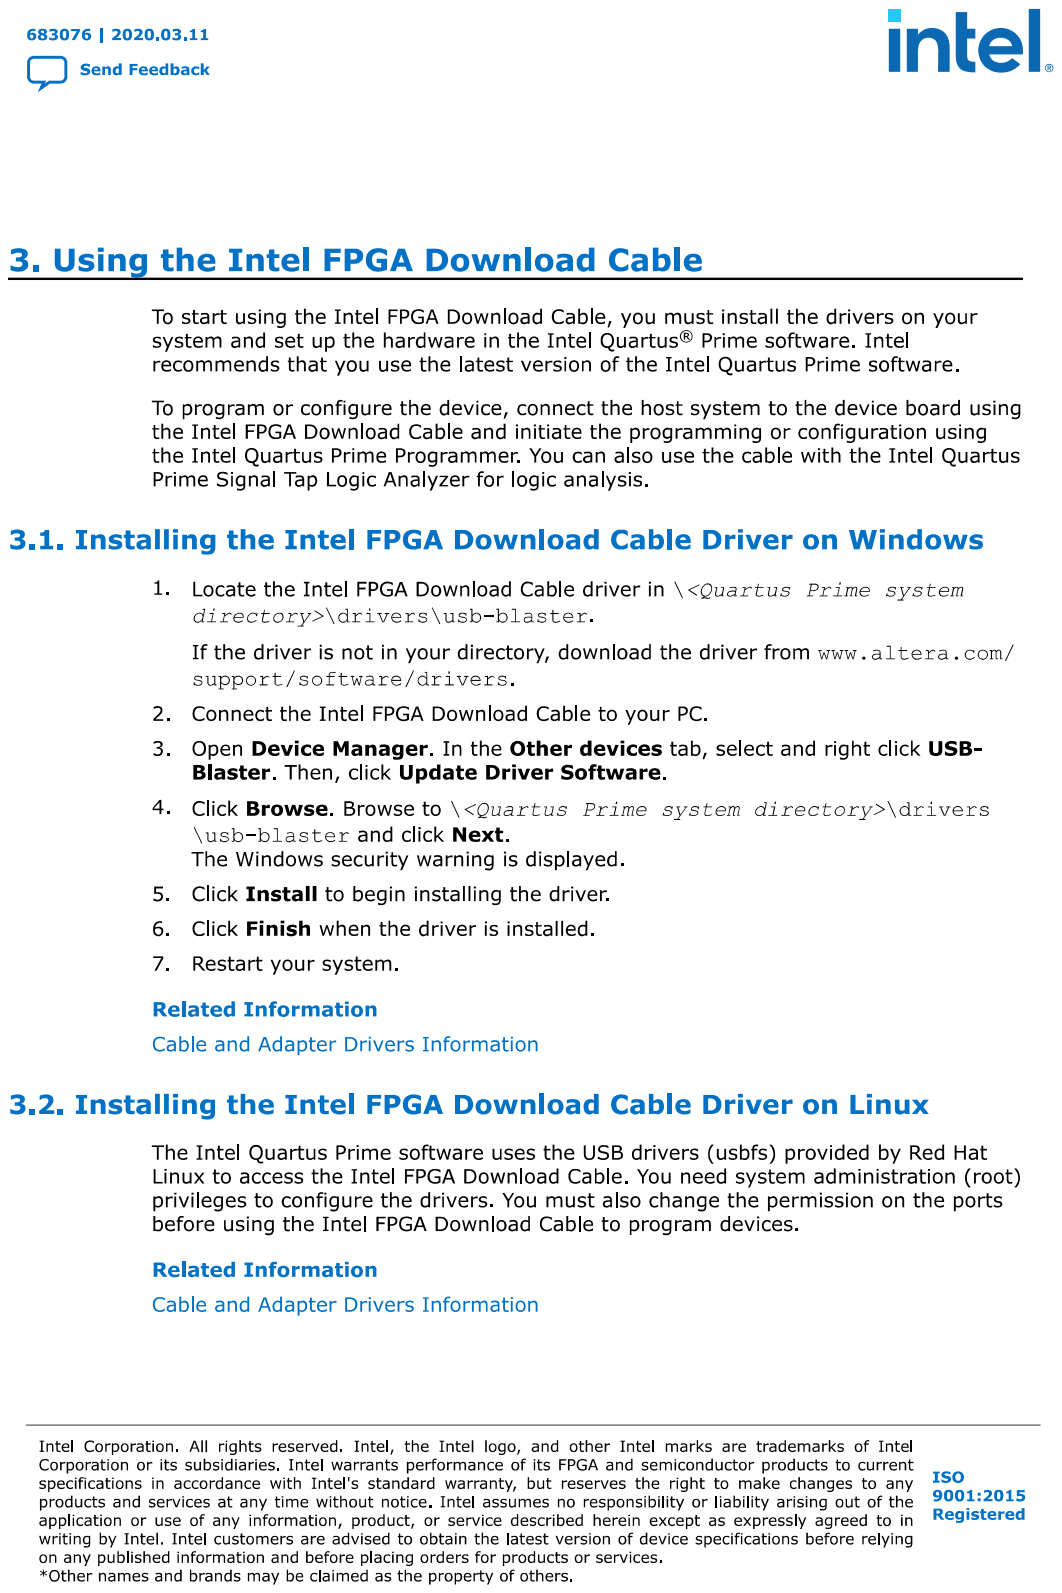
[picture p48: page 9]

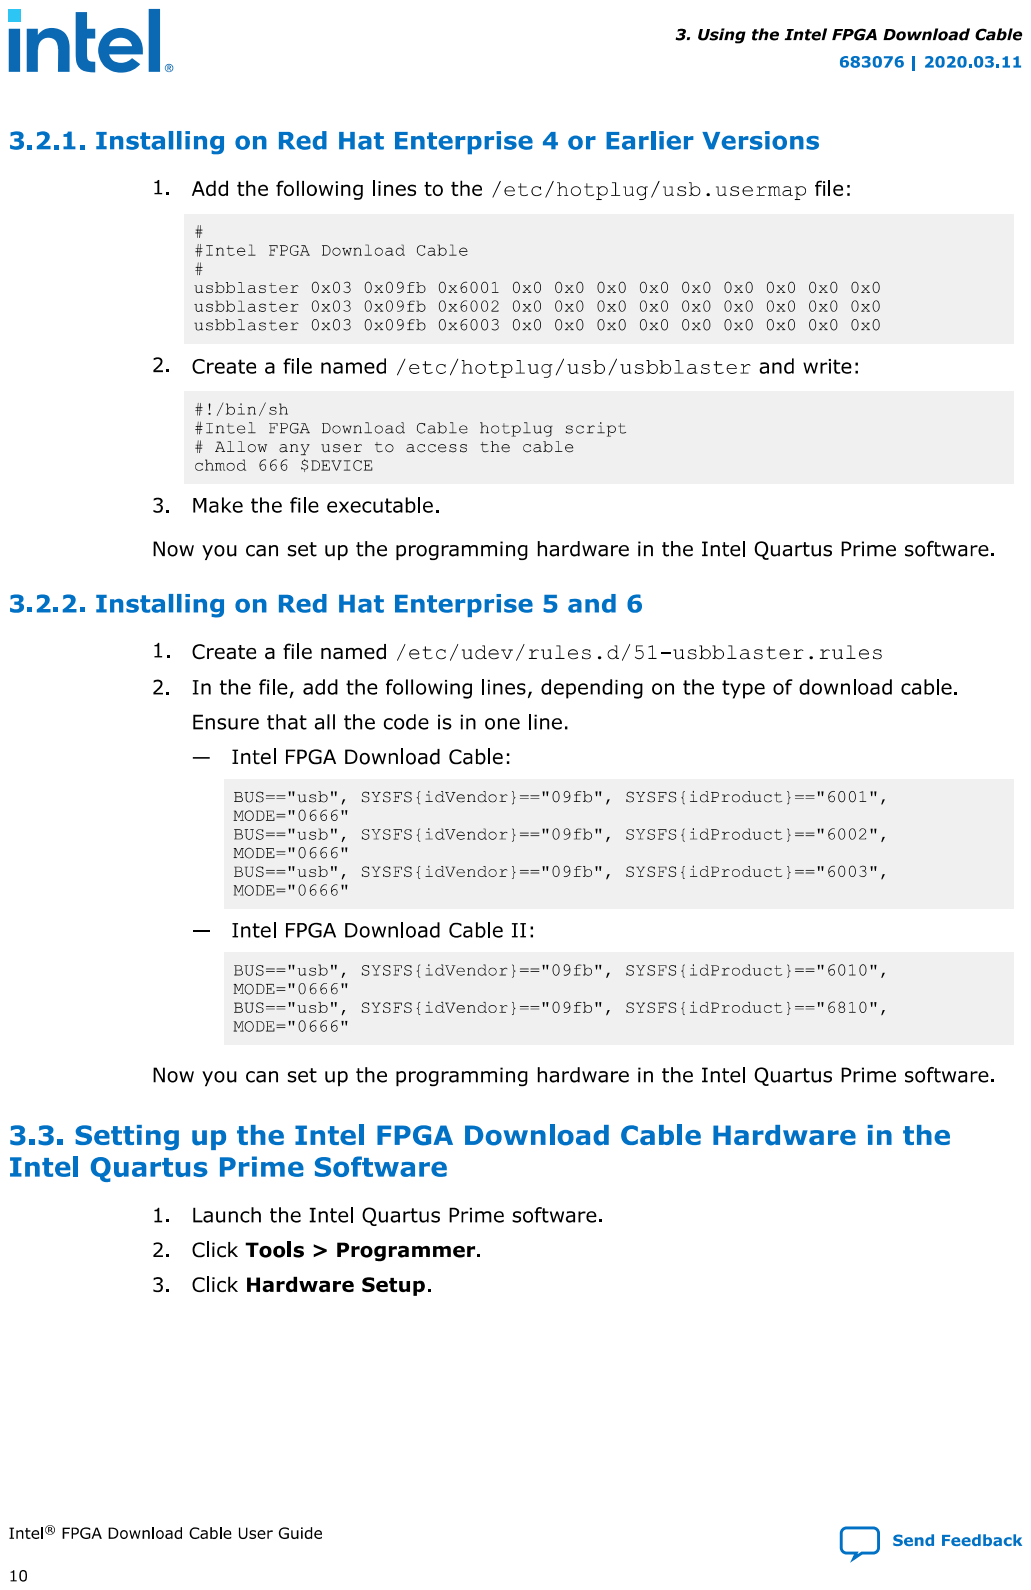
[picture p49: page 10]

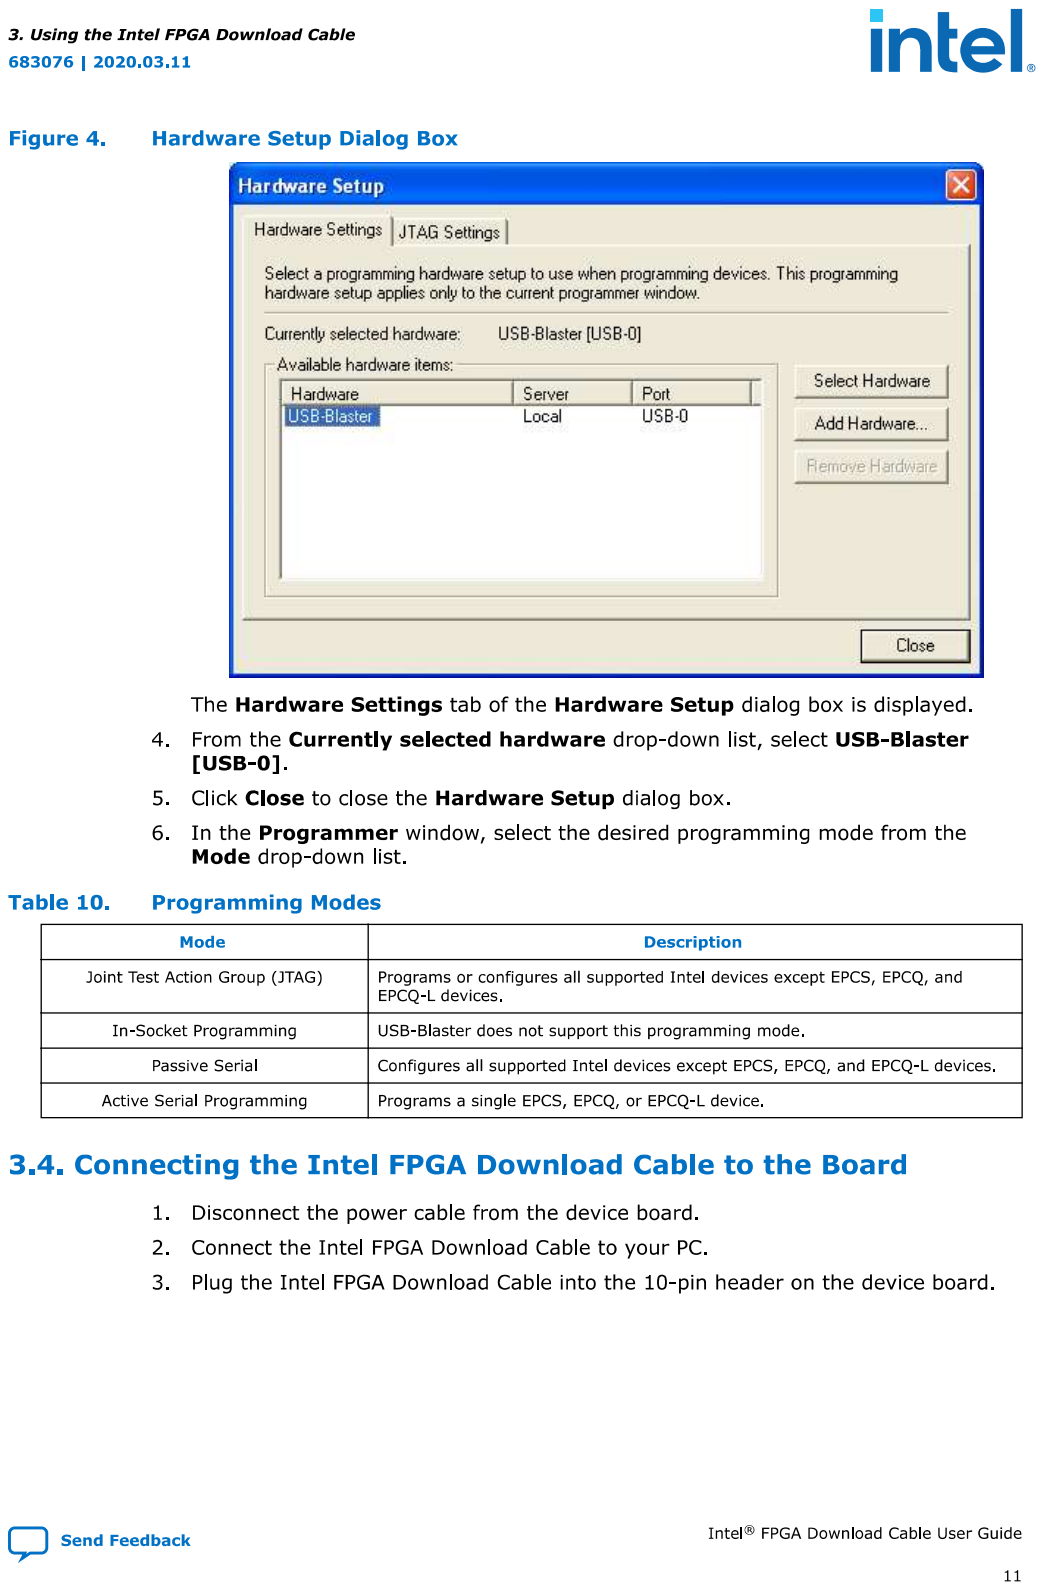
[picture p50: page 11]

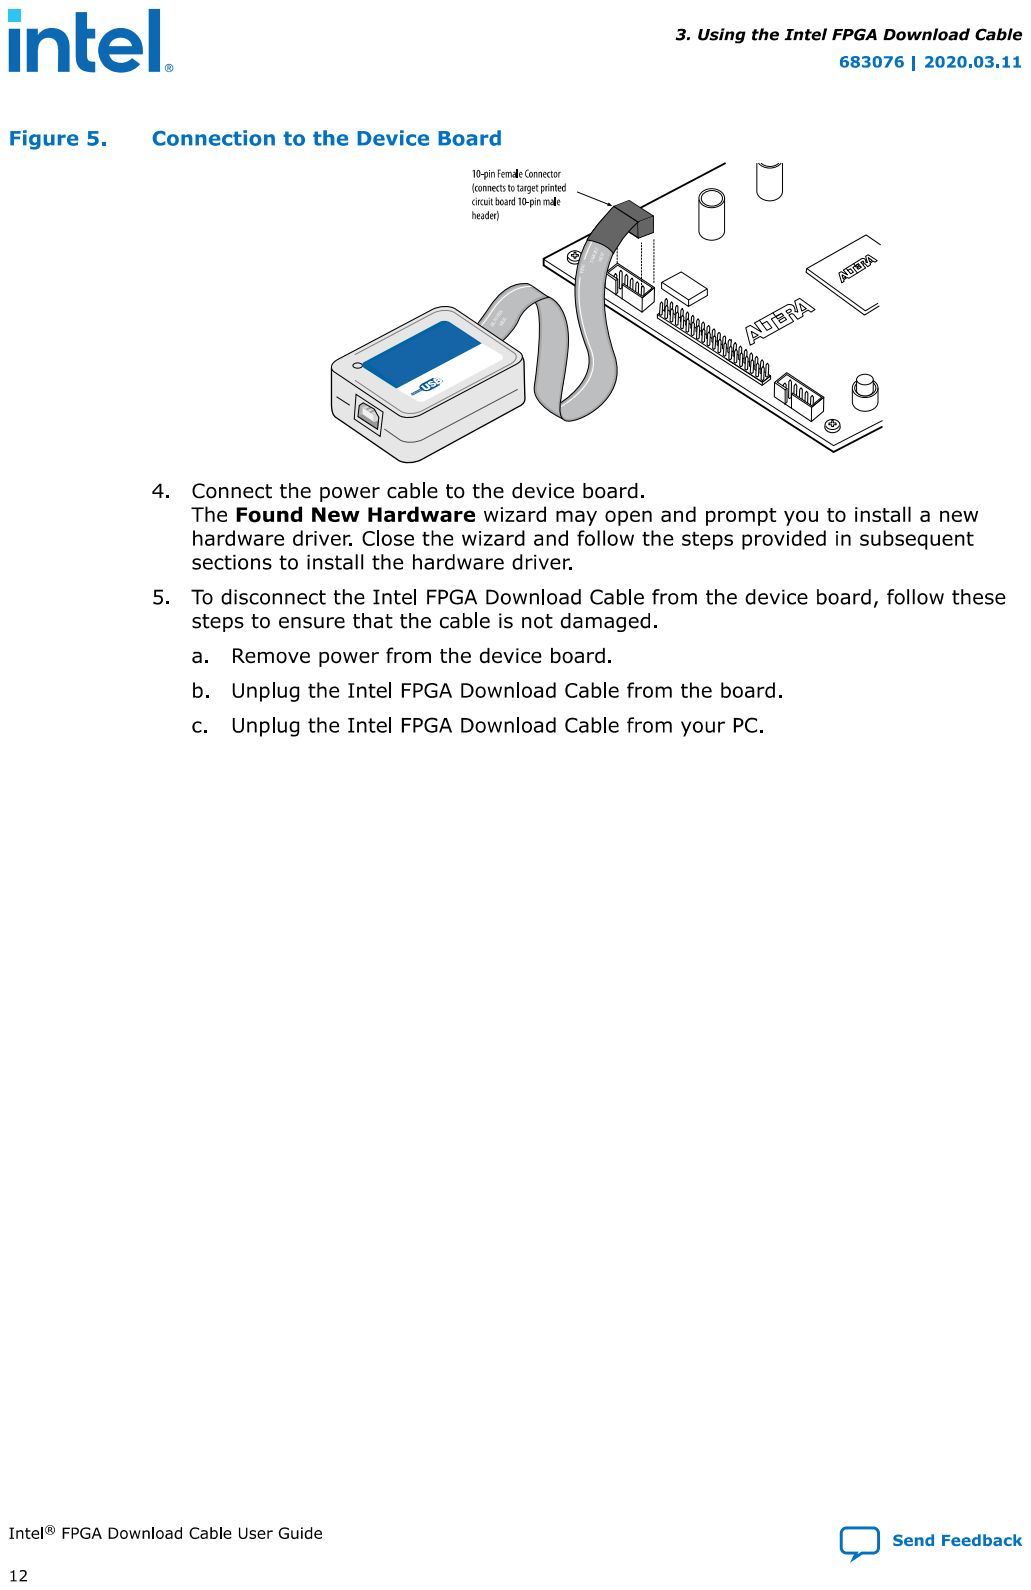
[picture p51: page 12]

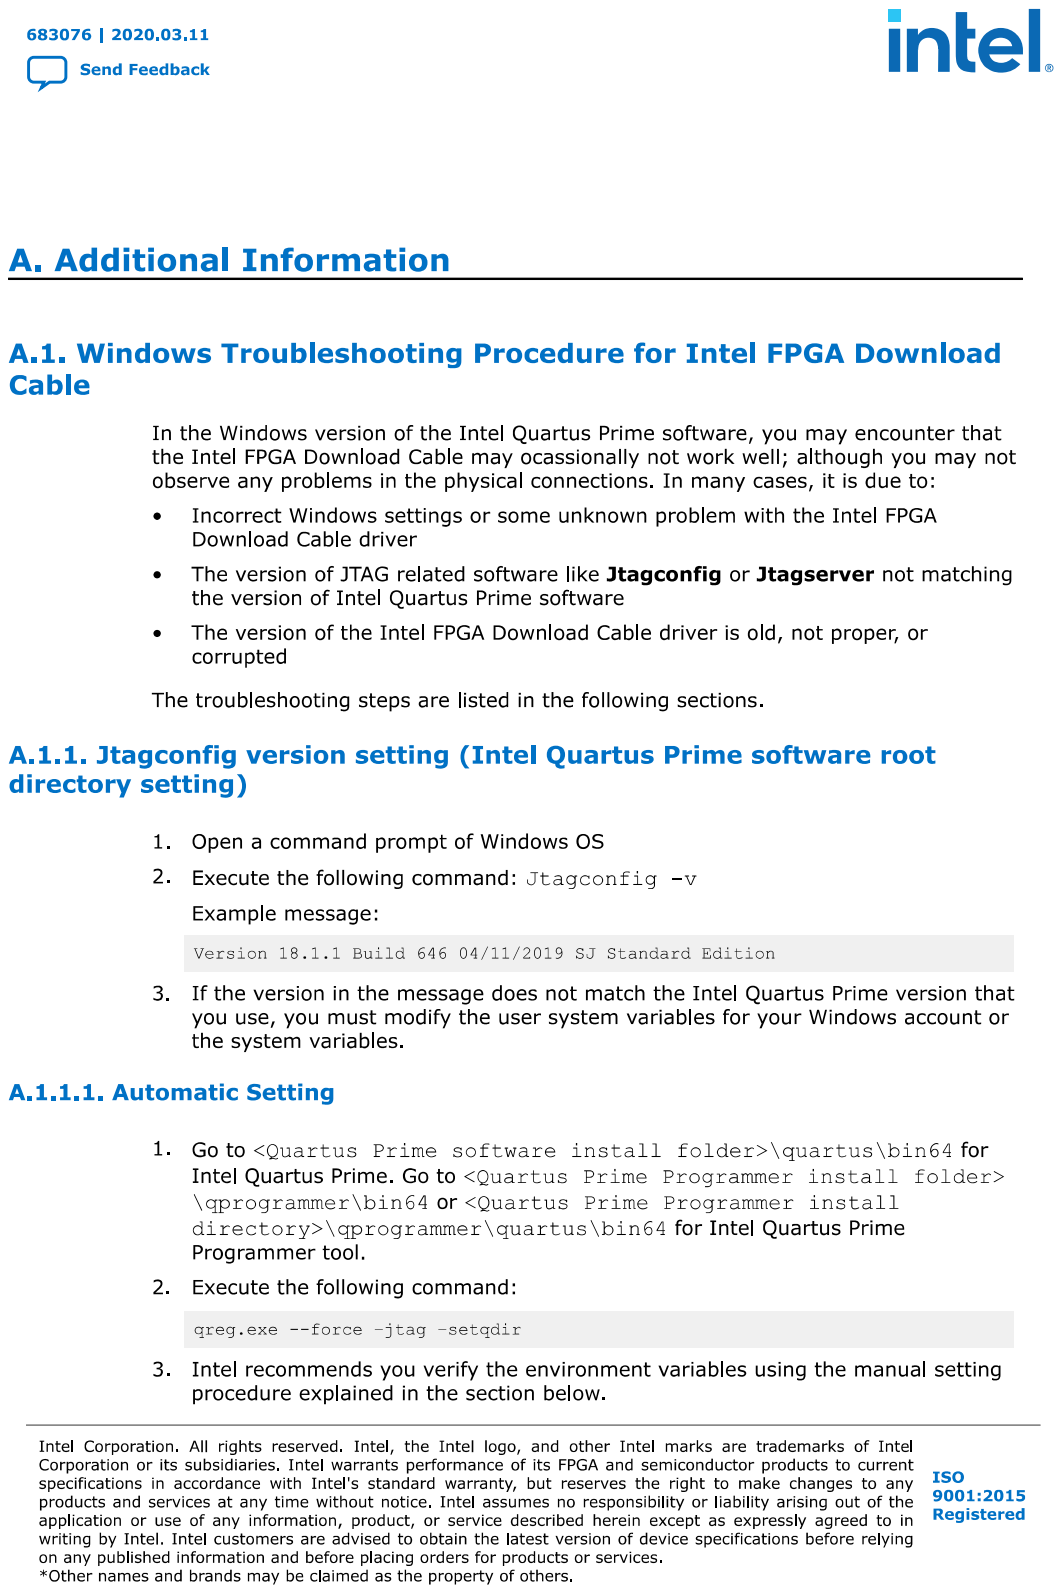
[picture p52: page 13]

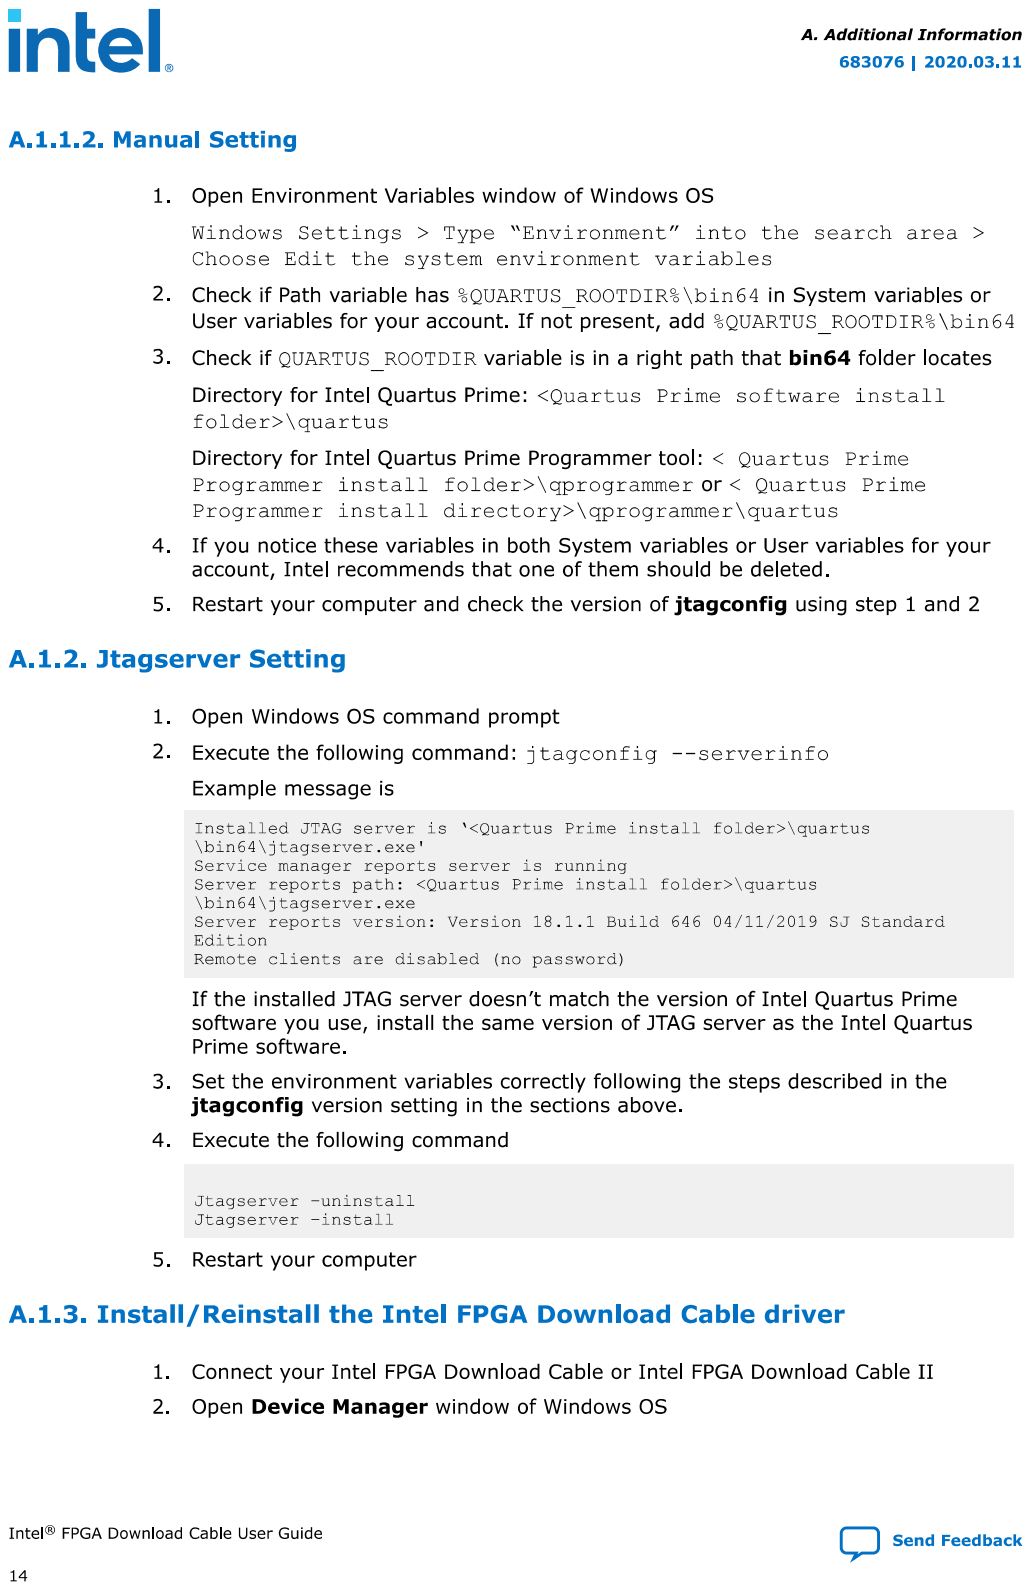
[picture p53: page 14]

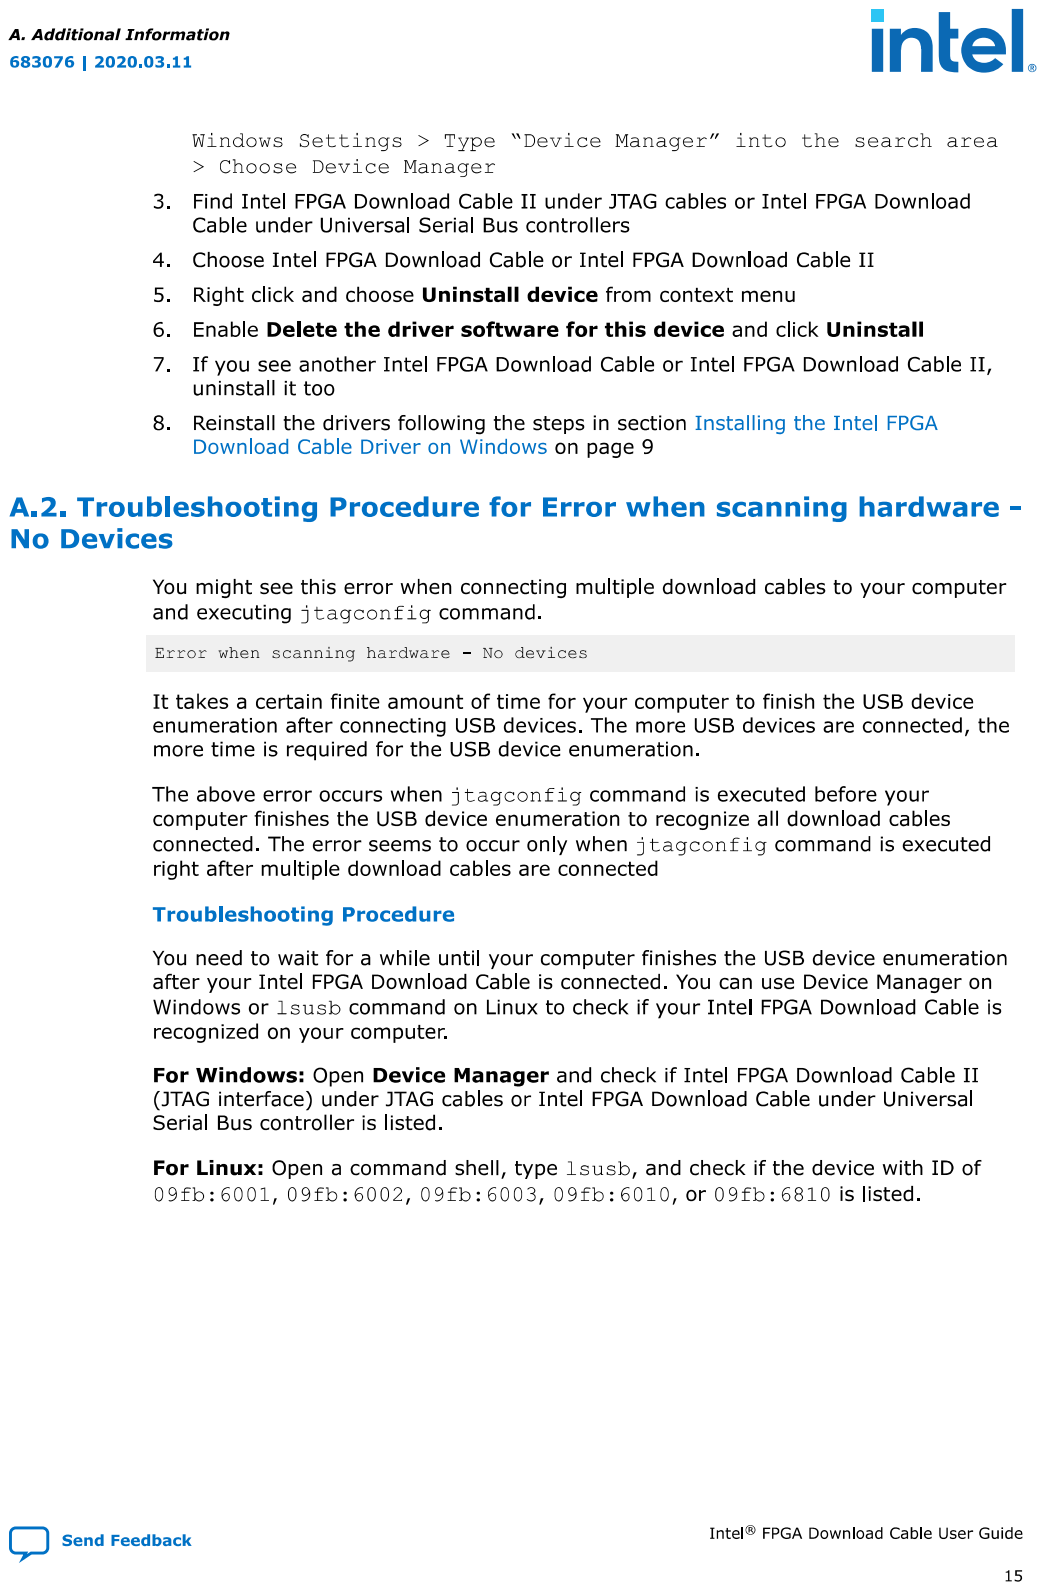
[picture p54: page 15]

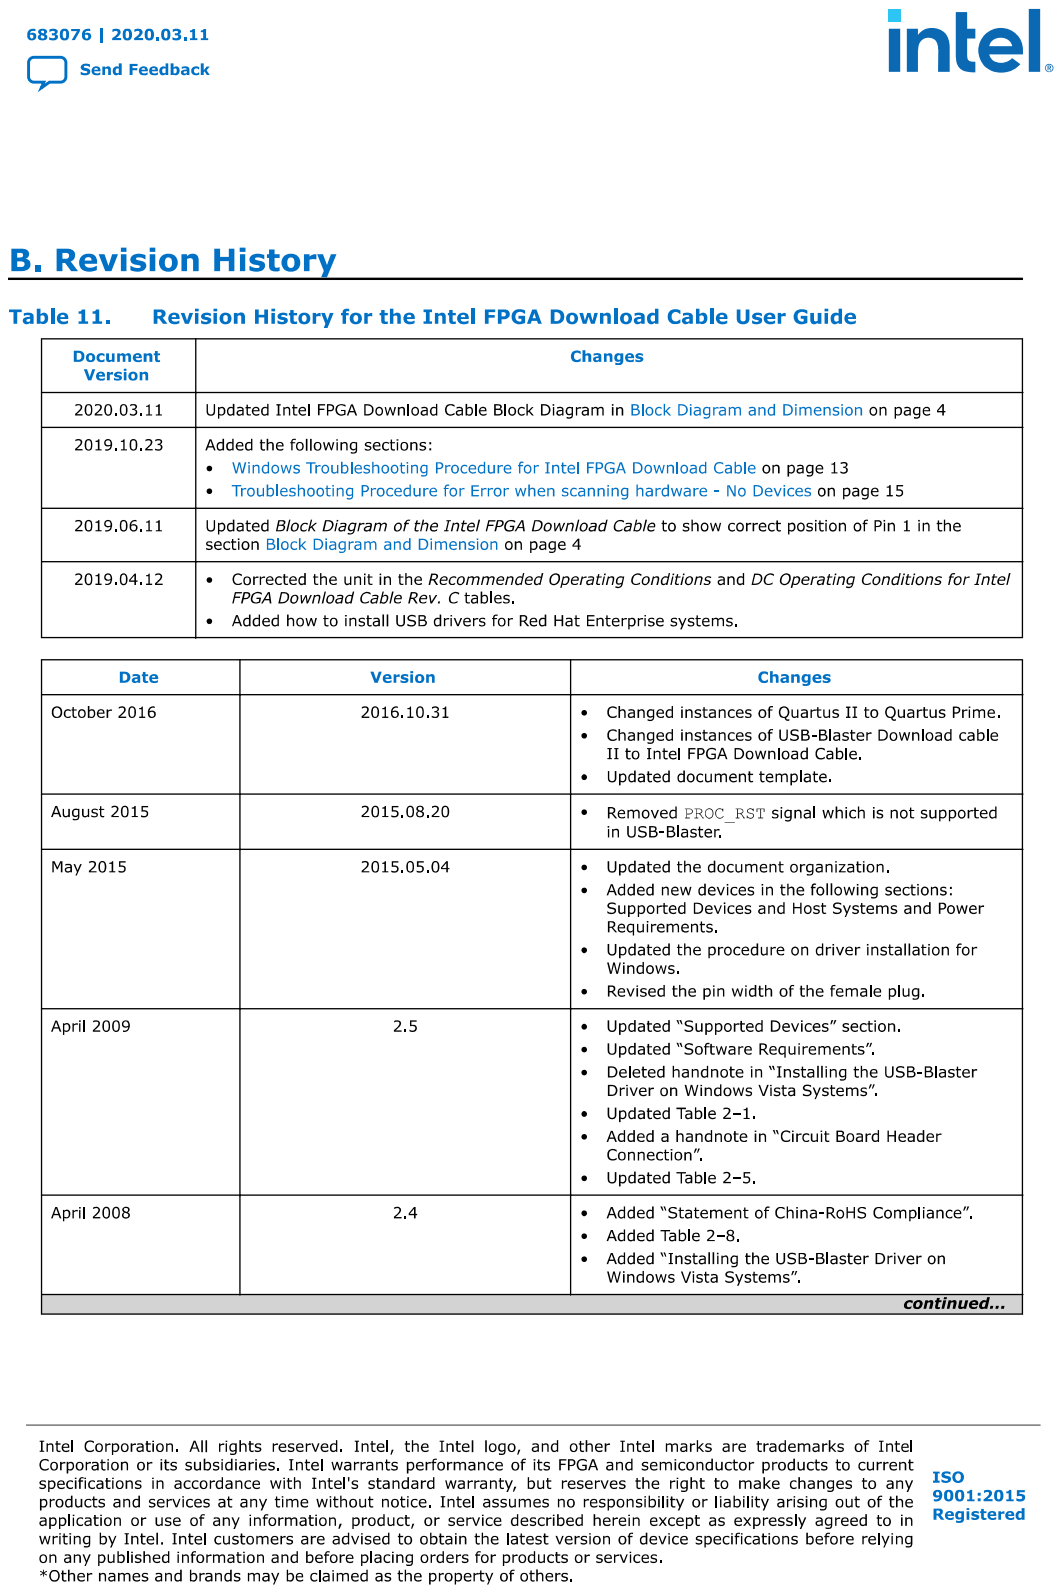
[picture p55: page 16]

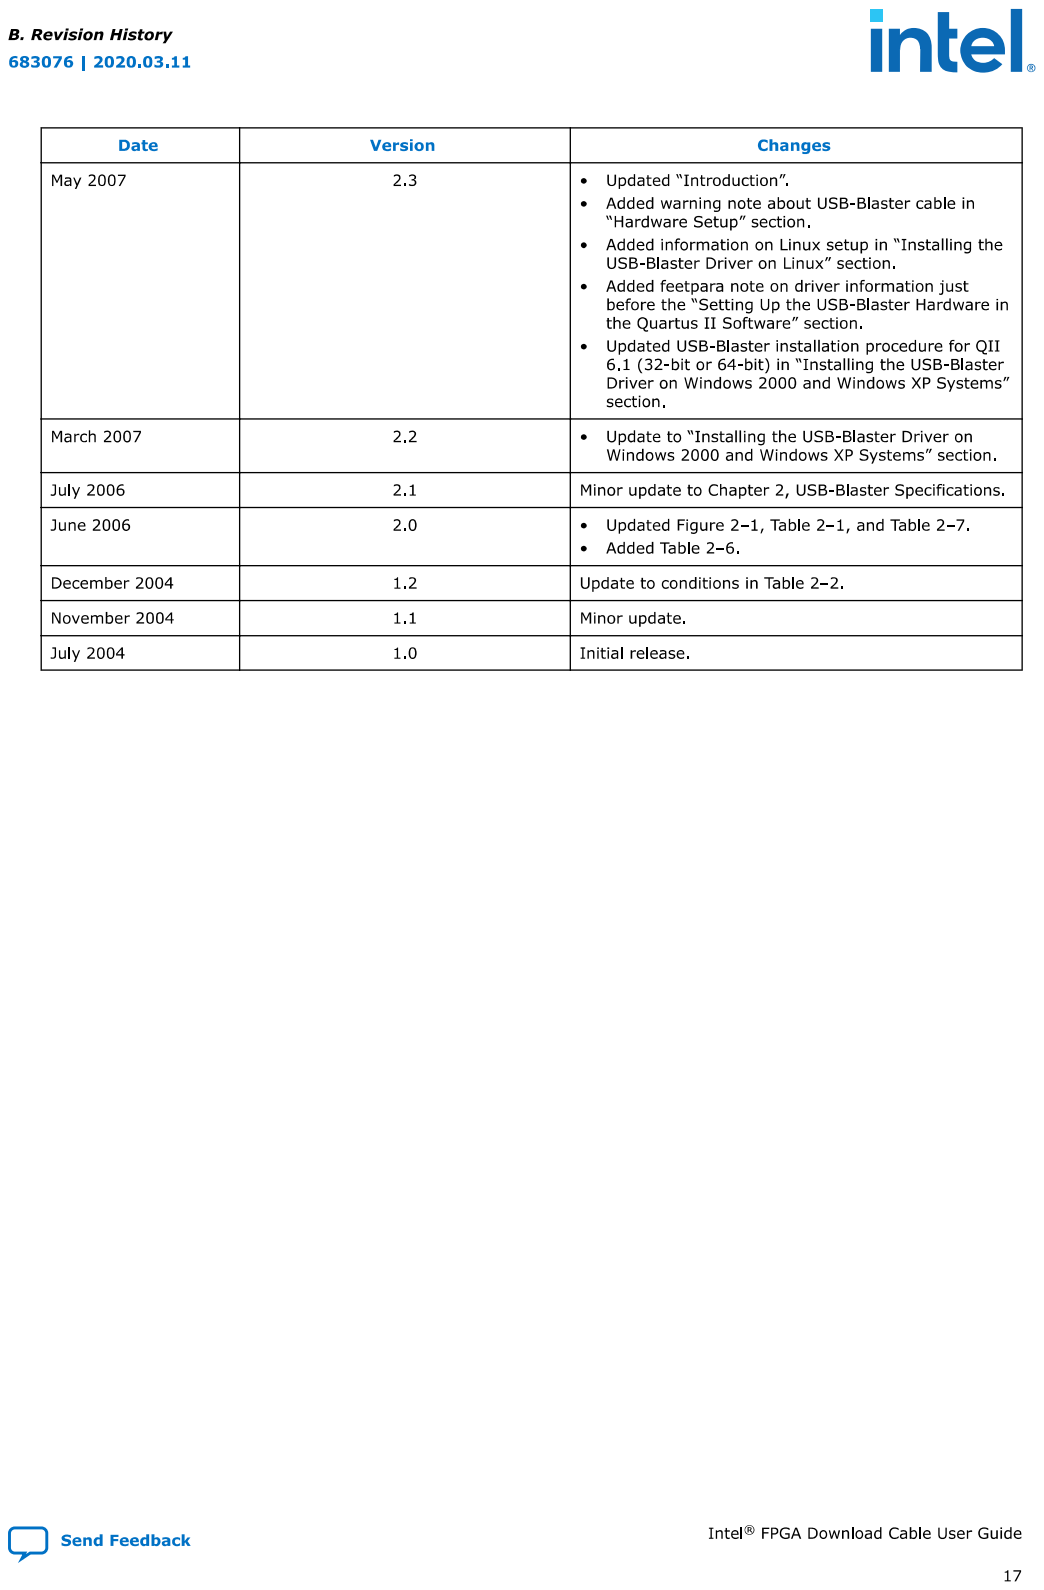
[picture p56: page 17]
