ssingh-tamu/The-Only-WGT-FinalGIT/(commit log)

2026-01-15 403 Finance Files
    [9_30.xlsx, 9_30_ Purchases.xlsx, Budget.xlsx]
2026-01-15 403 FPGA Files
    [Brayden Donovan Time Sheet.xlsx, FPGA Purchases 10_7.xlsx, PCB Purchase Request.xlsx]
2026-01-15 Mobile App and Enclosure
    [Budget for Mobile App_Enclosure.xlsx, Execution Plan - Deliverables Mapped.xlsx, Execution Plan - Updated.xlsx]
2026-01-15 403 Power and Filter Notes
2026-01-15 403 Project Deliverables
    [DEMO DATA_.xlsx]
